mushfiqbinmusa-ops/Laser_Engraver/Laser_XY_3D_Parts/images/IMG_2976.JPG

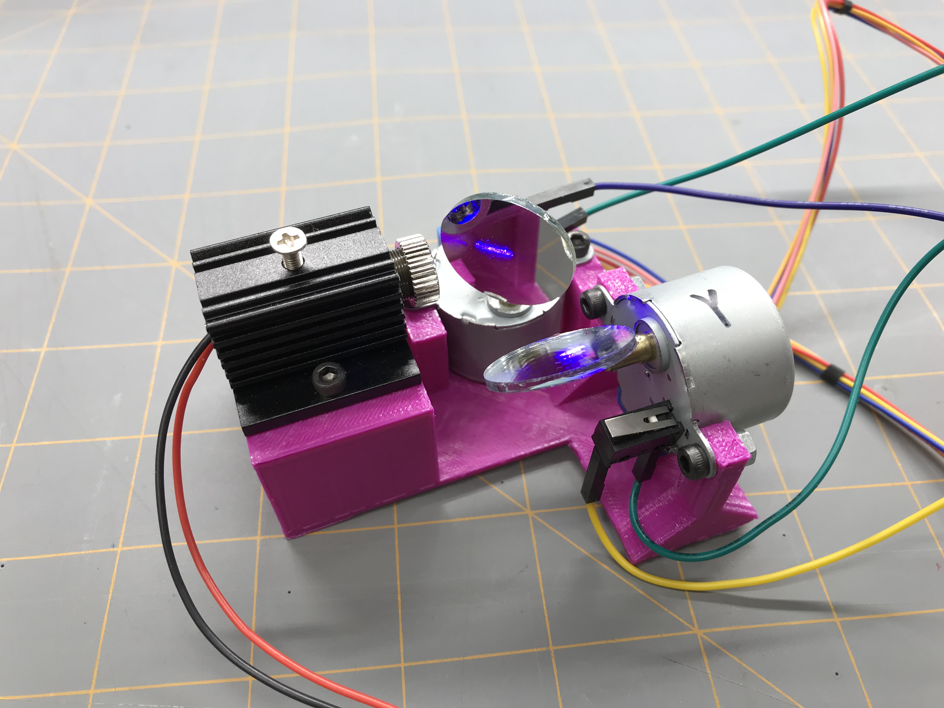
Laser_XY_3D_Parts/images/IMG_2976.JPG
