mushfiqbinmusa-ops/Laser_Engraver/Laser_XY_3D_Parts/images/Laser_XY_Scanner.png

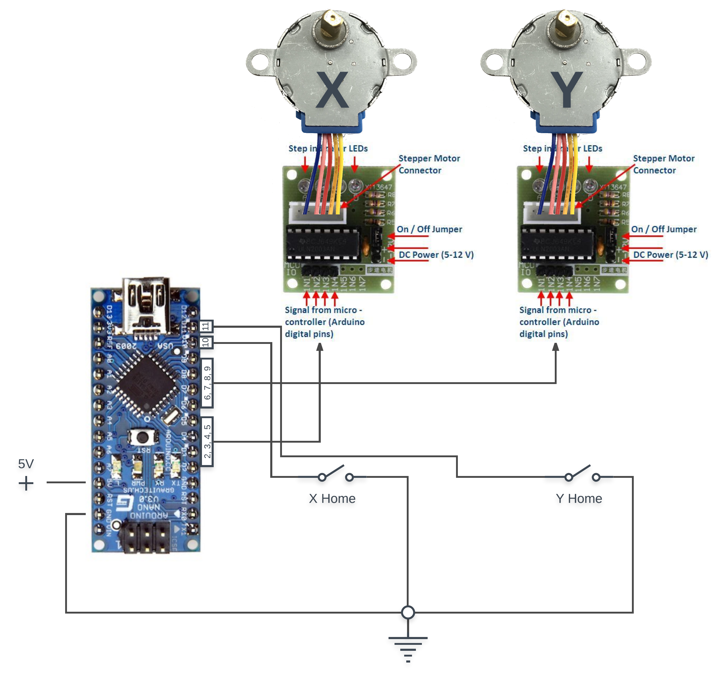
Laser_XY_3D_Parts/images/Laser_XY_Scanner.png
