mushfiqbinmusa-ops/Laser_Engraver/Laser_XY_3D_Parts/README.txt

Laser XY Scanner by thingengineer on Thingiverse: https://www.thingiverse.com/thing:2710048

Summary:
Laser XY ScannerLow Cost DIY 3D Printed stepper motor Laser XY Scanner - Draw, Cut, Engrave, or ScanLaser XY Scanner is an open source stepper motor based scanner.The components used are low cost and very accessible. This typeof laser scanner is not extremely fast but it can still be used in avariety of applications. Draw, cut and or point with laser X and Y control.The circuit:Arduino NanoMonitors small lever switches for X and Y home detection (minimum travel)Controls ULN2003APG high−current darlington driversDrives 28BYJ-48 5V Stepper Motors12V TTL 1W/1.6W/2W/445nm/450nm Laser Diode LD DriverDrives 2W 445nm M140 Blue Laser Diode w/ AixiZ aluminum mount and heat sink for 12mm modulesThe Arduino code can be found in the project repository.GitHub Project: https://github.com/ThingEngineer/Laser-XY-ScannerThe Instructable:https://www.instructables.com/id/Low-Cost-DIY-Stepper-Motor-Laser-XY-Scanner-Cutter/Video of the Laser XY Scanner in action:https://youtu.be/hbFObc3SvLU
