mushfiqbinmusa-ops/Laser_Engraver/resources/28byj48 stepper motor.jpeg

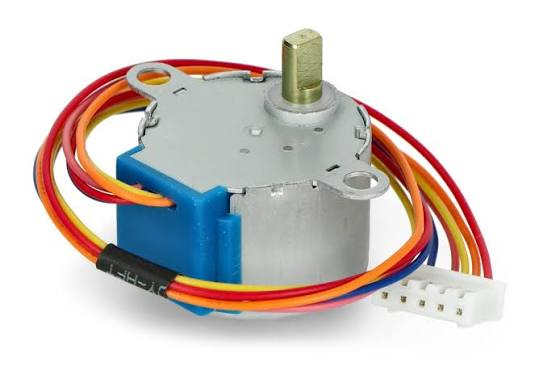
resources/28byj48 stepper motor.jpeg
