mushfiqbinmusa-ops/Laser_Engraver/resources/A4988-Stepper-Motor-Driver-Pinout.webp

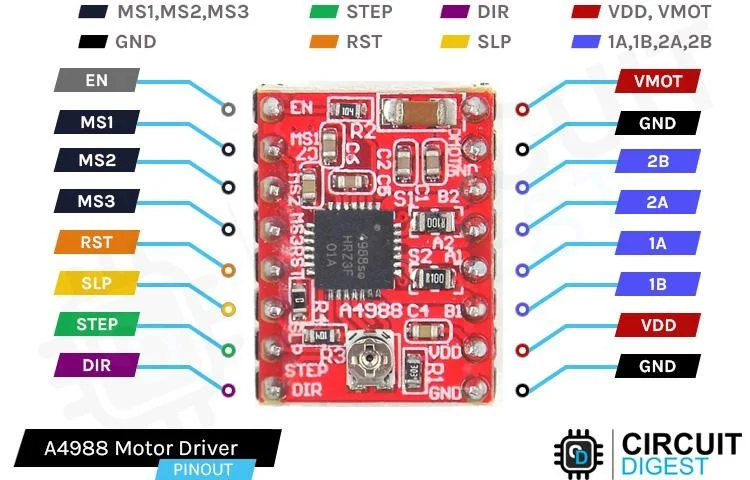
resources/A4988-Stepper-Motor-Driver-Pinout.webp
