mushfiqbinmusa-ops/Laser_Engraver/resources/Infrared Obstacle Avoidance IR Sensor Module.jpeg

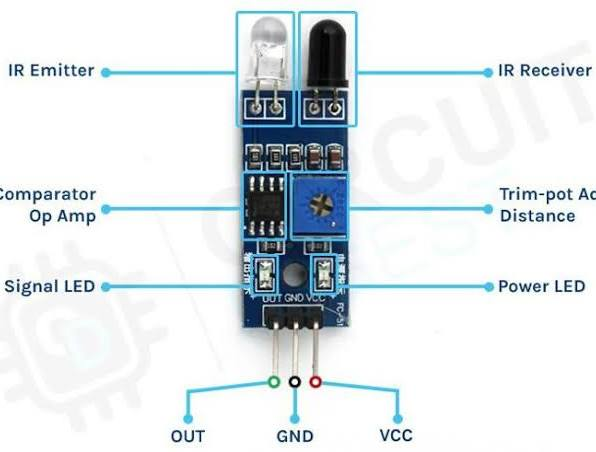
resources/Infrared Obstacle Avoidance IR Sensor Module.jpeg
