mushfiqbinmusa-ops/Laser_Engraver/resources/laser_back_01.jpg

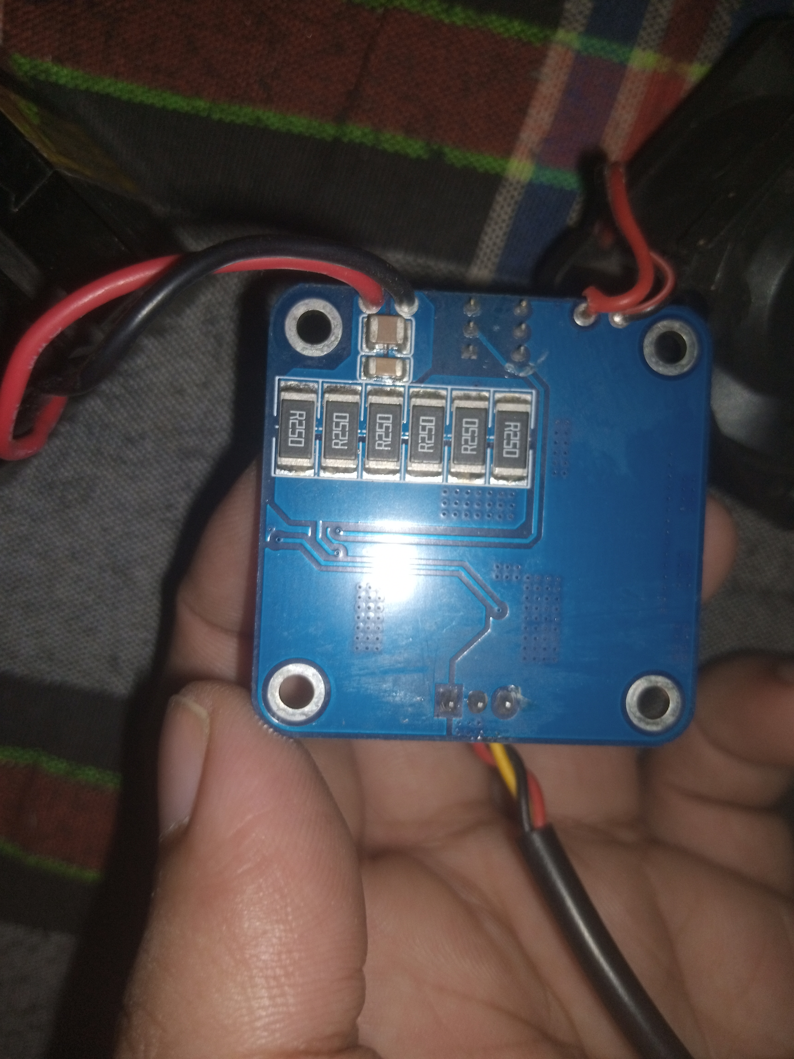
resources/laser_back_01.jpg
