mushfiqbinmusa-ops/Laser_Engraver/resources/laser_front_01.jpg

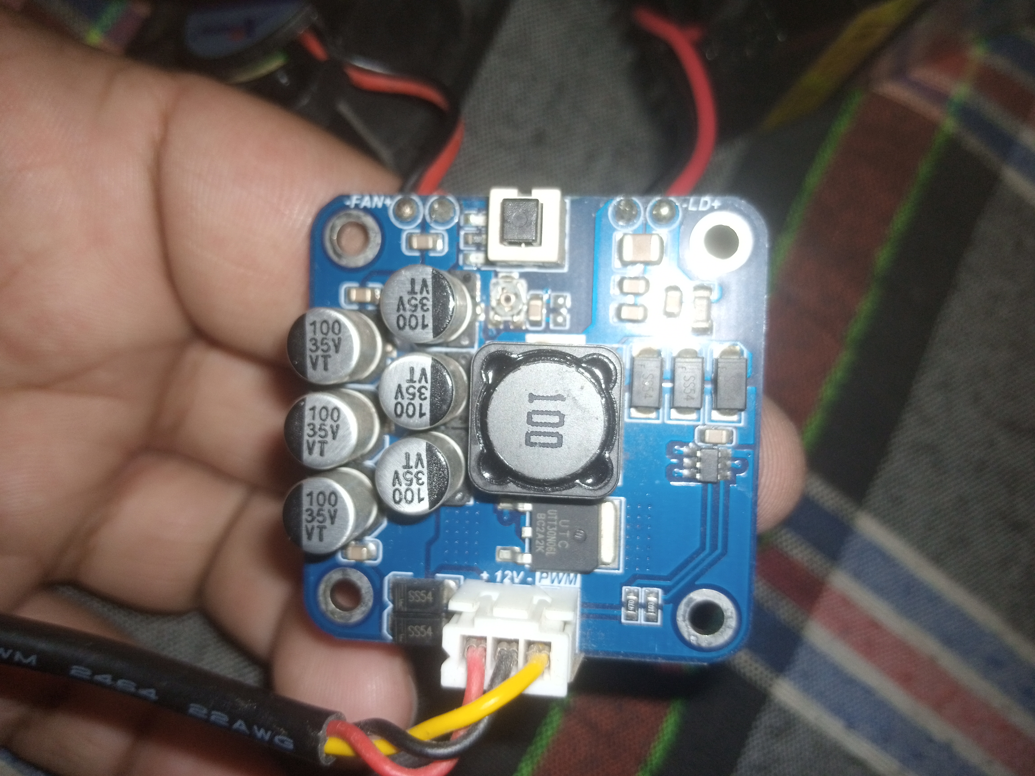
resources/laser_front_01.jpg
