mushfiqbinmusa-ops/Laser_Engraver/resources/laser_front_02.jpg

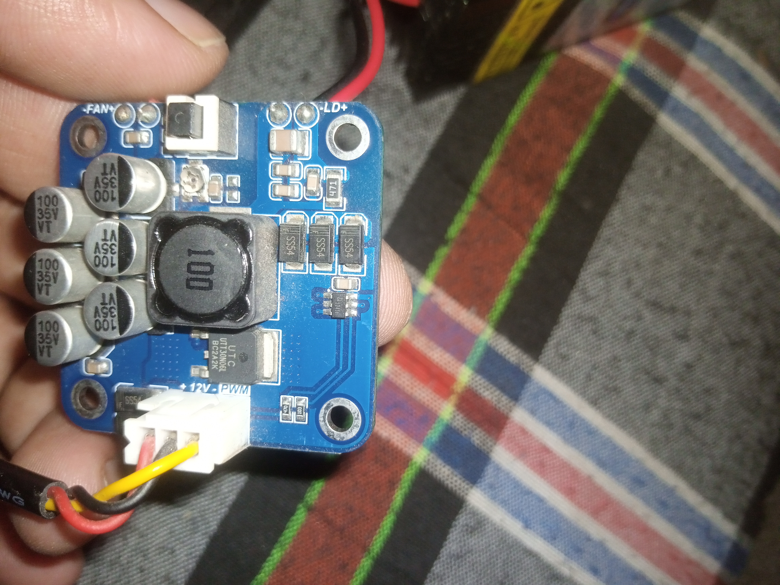
resources/laser_front_02.jpg
