mushfiqbinmusa-ops/Laser_Engraver/Laser XY 3D Parts/images/27eb95fb827bb4617622e574c83647a1.png

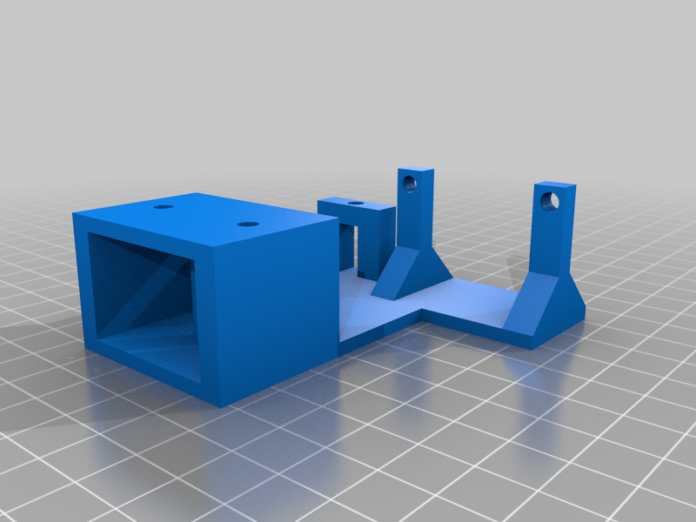
Laser XY 3D Parts/images/27eb95fb827bb4617622e574c83647a1.png
