mushfiqbinmusa-ops/Laser_Engraver/Laser XY 3D Parts/images/Laser_XY_Scanner_2.png

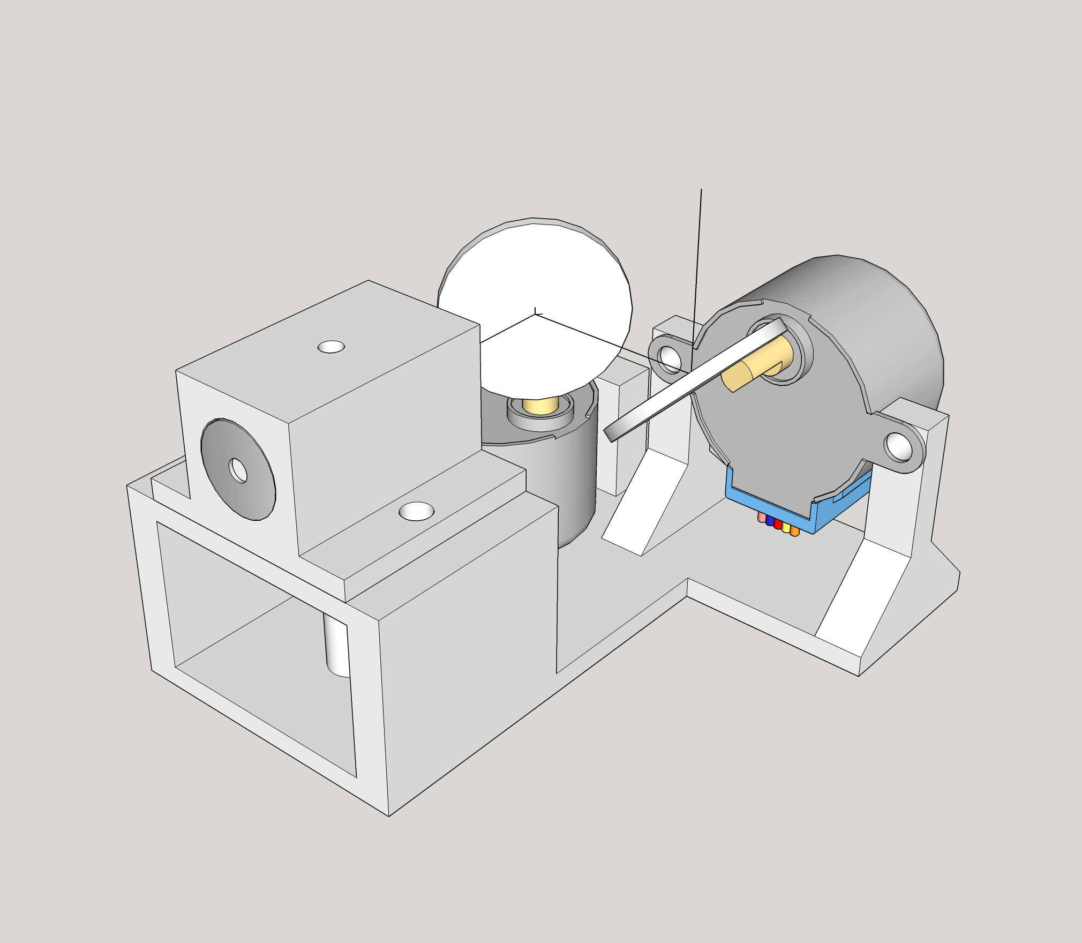
Laser XY 3D Parts/images/Laser_XY_Scanner_2.png
