mushfiqbinmusa-ops/Laser_Engraver/Laser XY 3D Parts/images/Laser_XY_Scanner_3.png

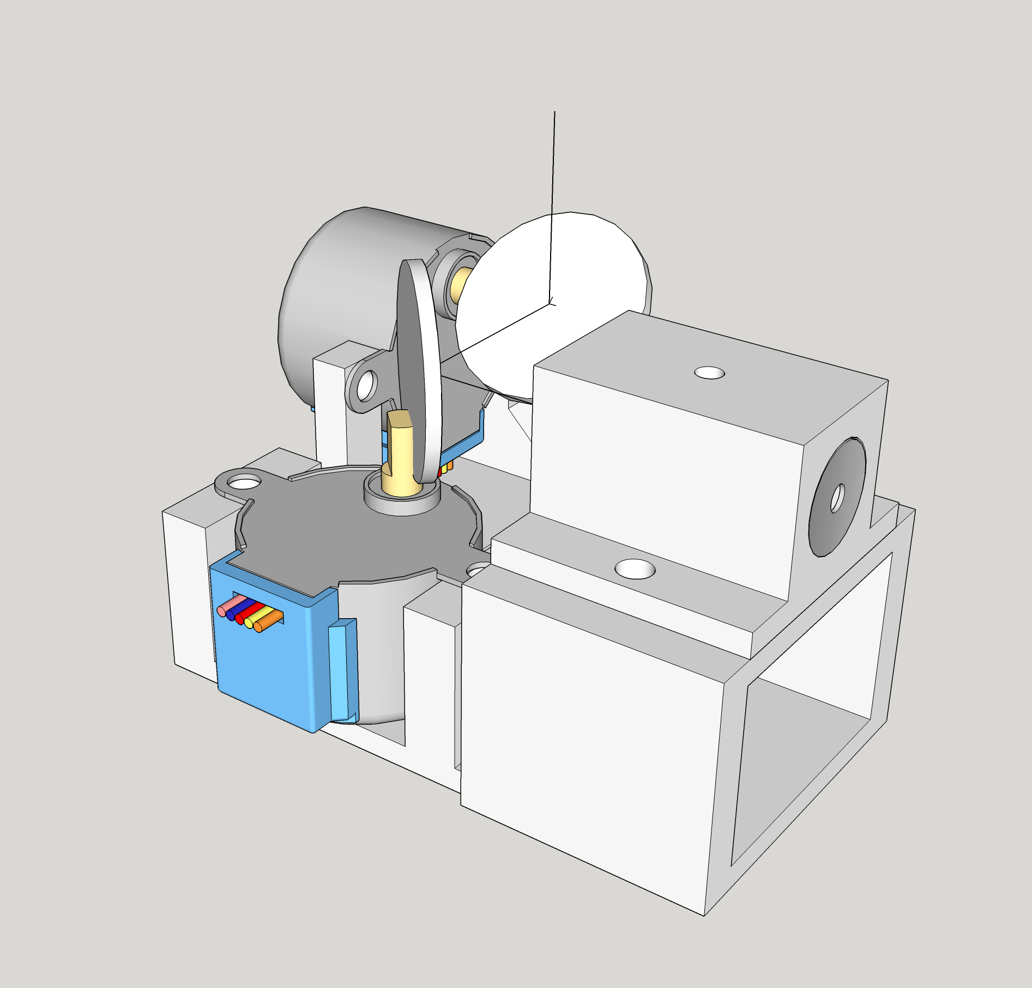
Laser XY 3D Parts/images/Laser_XY_Scanner_3.png
