mushfiqbinmusa-ops/Laser_Engraver/Laser_XY_3D_Parts/images/IMG_2973.JPG

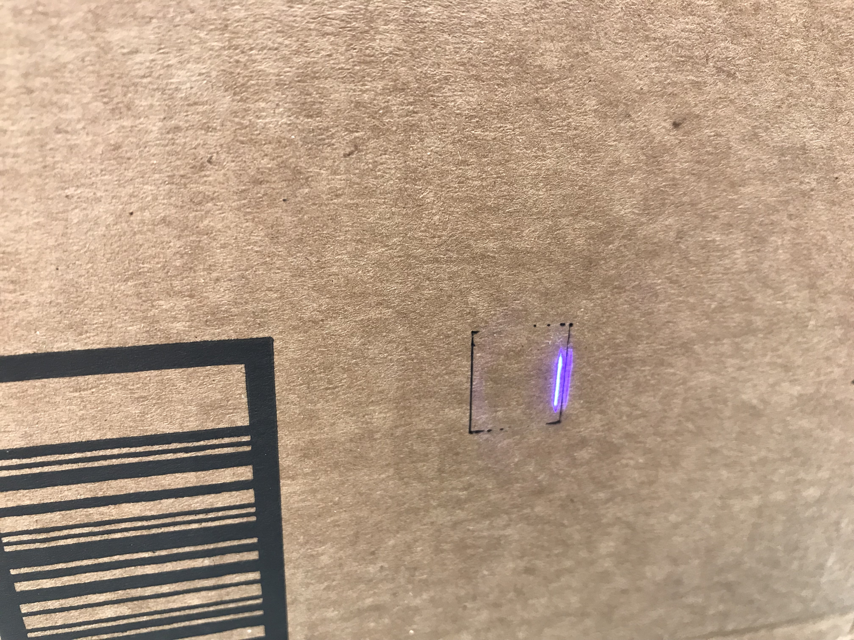
Laser_XY_3D_Parts/images/IMG_2973.JPG
