mushfiqbinmusa-ops/Laser_Engraver/Laser_XY_3D_Parts/images/Laser_XY_Scanner_4.png

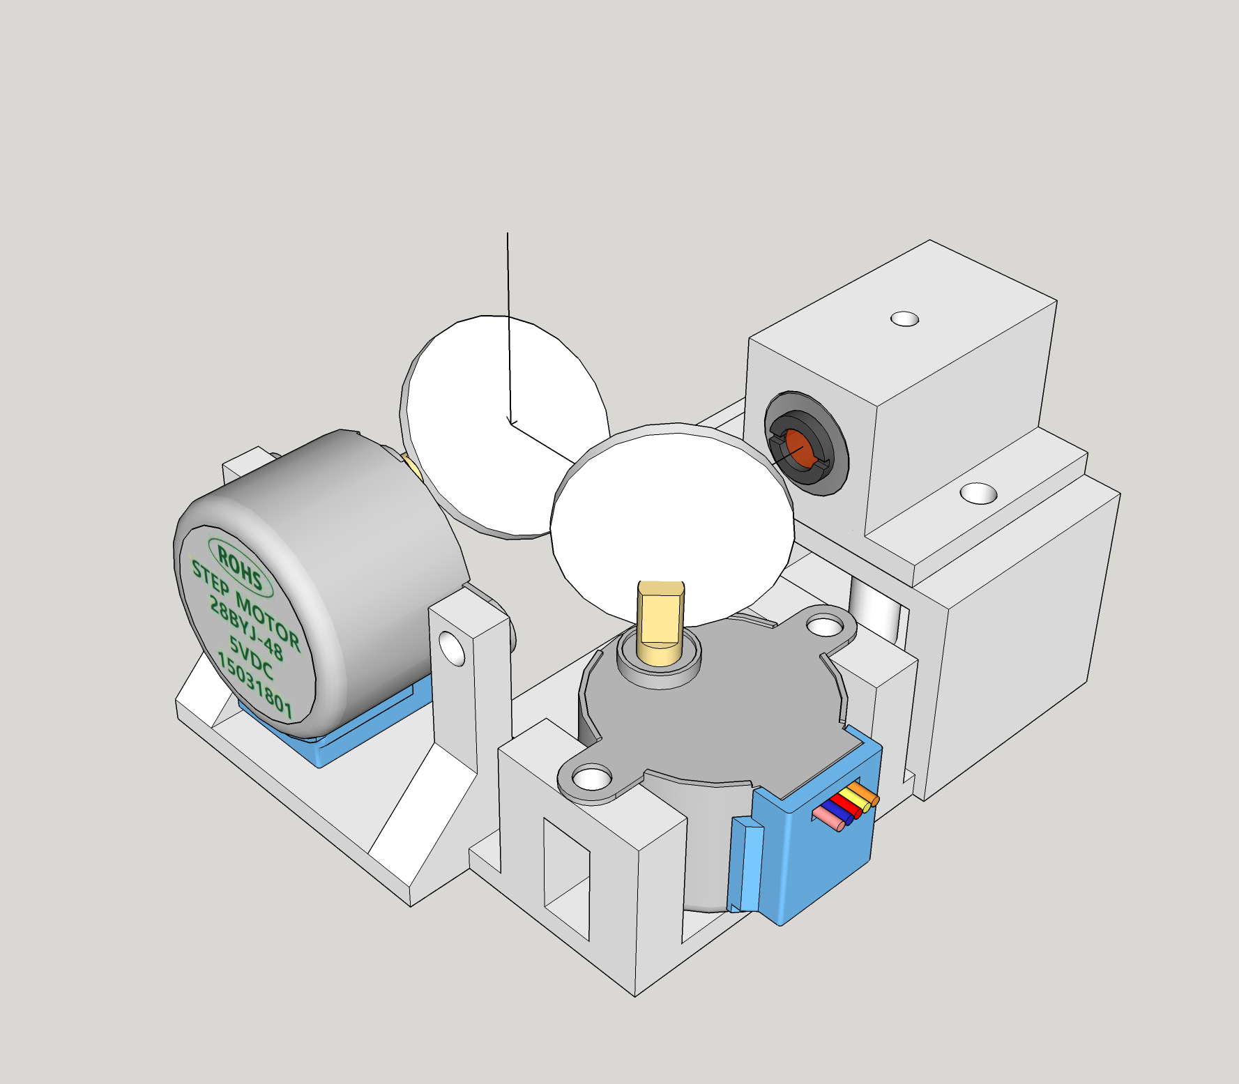
Laser_XY_3D_Parts/images/Laser_XY_Scanner_4.png
