mushfiqbinmusa-ops/Laser_Engraver/Laser_XY_3D_Parts/files/Laser_XY_Scanner.stl

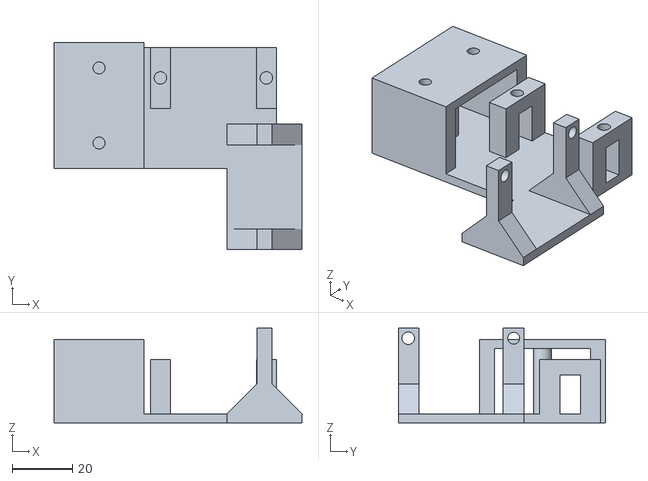
[picture p15: CAD file, 2026-10-16]
Laser_XY_3D_Parts/files/Laser_XY_Scanner.stl
82.5 x 69.0 x 31.6
