mushfiqbinmusa-ops/Laser_Engraver/(list of files, cad)

Other CAD files:
Laser XY 3D Parts/files/Laser_XY_Scanner.skp
Laser_XY_3D_Parts/files/ESP32-S3_SUPERMINI2.glb.skp
