mushfiqbinmusa-ops/Laser_Engraver/stepper_motor_test/TESTING_GUIDE.md

# Dual Stepper Motor & A4988 Driver Test Guide

**Sketch location:** `stepper_motor_test/stepper_motor_test.ino`  
**Target Board:** ESP32-S3 SuperMini  
**Motors:** Dual 28BYJ-48 Stepper Motors (Converted to 4-Wire Bipolar)  
**Drivers:** Dual Allegro A4988 Microstepping Drivers  
**Power Rails:** 5V VMOT (Motor Power) | 3.3V VDD (Logic from ESP32-S3)  
**No external libraries required** — uses standard ESP32 Arduino Core.

---

## Table of Contents

1. [System Architecture & Block Diagram](#1-system-architecture--block-diagram)
2. [28BYJ-48 Bipolar Conversion Guide](#2-28byj-48-bipolar-conversion-guide)
3. [A4988 Driver Specifics & Vref Current Calibration](#3-a4988-driver-specifics--vref-current-calibration)
4. [Circuit Wiring Diagrams & Detailed Component Schematics](#4-circuit-wiring-diagrams--detailed-component-schematics)
   - [Single Motor Test Wiring (Motor A Only)](#41-single-motor-test-wiring-motor-a-only)
   - [Dual Motor Test Wiring (Motor A + Motor B)](#42-dual-motor-test-wiring-motor-a--motor-b)
   - [Capacitor Selection Analysis (Addressing Your Inventory)](#43-capacitor-selection-analysis-addressing-your-inventory)
   - [Step-by-Step Written Wiring Instructions (Foolproof Breadboard Guide)](#44-step-by-step-written-wiring-instructions-foolproof-breadboard-guide)
5. [Microstepping Resolution & Kinematics Table](#5-microstepping-resolution--kinematics-table)
6. [Arduino IDE & Board Configuration](#6-arduino-ide--board-configuration)
7. [Phase-by-Phase Testing Roadmap](#7-phase-by-phase-testing-roadmap)
   - [Phase 1: Cold Logic Verification (VMOT OFF)](#phase-1-cold-logic-verification-vmot-off)
   - [Phase 2: Motor A Rotation & Direction (VMOT ON)](#phase-2-motor-a-rotation--direction-vmot-on)
   - [Phase 3: Speed Characterisation & Stall Limit](#phase-3-speed-characterisation--stall-limit)
   - [Phase 4: Microstepping Transitions (1/1 to 1/16)](#phase-4-microstepping-transitions-11-to-116)
   - [Phase 5: Gear Backlash Characterisation](#phase-5-gear-backlash-characterisation)
   - [Phase 6: Dual-Axis Coordinated Vectoring (Square, Circle)](#phase-6-dual-axis-coordinated-vectoring-square-circle)
   - [Phase 7: Full Automated Self-Test & Benchmark](#phase-7-full-automated-self-test--benchmark)
8. [Troubleshooting Guide](#8-troubleshooting-guide)
9. [Serial Command Reference](#9-serial-command-reference)

---

## 1. System Architecture & Block Diagram

```mermaid
flowchart TD
    subgraph Power["Power Architecture"]
        USB["USB-C 5V Supply"] --> ESP32["ESP32-S3 SuperMini"]
        ESP32 -->|"3.3V Logic Rail"| VDD["VDD (A4988 Logic)"]
        EXT_5V["External 5V / 2A Supply"] -->|"5V VMOT Rail"| VMOT["VMOT (A4988 Motor Power)"]
        GND_SYS["Common Ground Rail (GND)"] --- ESP32
        GND_SYS --- EXT_5V
    end

    subgraph Controller["ESP32-S3 SuperMini"]
        IO5["GPIO 5 (STEP_A)"]
        IO6["GPIO 6 (DIR_A)"]
        IO7["GPIO 7 (EN_A)"]
        IO9["GPIO 9 (STEP_B)"]
        IO10["GPIO 10 (DIR_B)"]
        IO11["GPIO 11 (EN_B)"]
        MS_BUS["Shared Microstep Bus\nGPIO 1 (MS1)\nGPIO 2 (MS2)\nGPIO 4 (MS3)"]
        IO13["GPIO 13 (Status LED)"]
    end

    subgraph Drivers["A4988 Stepper Drivers"]
        subgraph DriverA["Driver A (X-Axis)"]
            DRV_A["A4988 Driver Module"]
            CAP_A["100uF Electrolytic Decoupling Cap"]
        end
        subgraph DriverB["Driver B (Y-Axis)"]
            DRV_B["A4988 Driver Module"]
            CAP_B["100uF Electrolytic Decoupling Cap"]
        end
    end

    subgraph Motors["28BYJ-48 Steppers (Bipolar Mod)"]
        MOT_A["Motor A (X Steering Mirror)\nCoil 1: Blue/Yellow\nCoil 2: Pink/Orange"]
        MOT_B["Motor B (Y Steering Mirror)\nCoil 1: Blue/Yellow\nCoil 2: Pink/Orange"]
    end

    IO5 --> DRV_A
    IO6 --> DRV_A
    IO7 --> DRV_A
    IO9 --> DRV_B
    IO10 --> DRV_B
    IO11 --> DRV_B
    MS_BUS --> DRV_A
    MS_BUS --> DRV_B

    VMOT --> CAP_A --> DRV_A
    VMOT --> CAP_B --> DRV_B
    VDD --> DRV_A
    VDD --> DRV_B

    DRV_A --> MOT_A
    DRV_B --> MOT_B
```

---

## 2. 28BYJ-48 Bipolar Conversion Guide

The stock 28BYJ-48 is a 5-wire unipolar stepper driven by Darlington arrays (e.g. ULN2003A). In unipolar mode, only half of each coil carries current at any given instant. 

By converting the motor to a **4-wire bipolar configuration**, both phases are driven symmetrically by an H-bridge driver (A4988), doubling torque production, improving efficiency, and allowing microstepping.

### Step-by-Step Conversion Procedure

1. **Remove Blue Plastic Cover:**
   - Gently pry the small tabs of the blue plastic cap on the rear of the 28BYJ-48 using a hobby knife or flat miniature screwdriver.
   - Slide the cap off to expose the internal small printed circuit board (PCB) where the 5 colored leads are soldered.

2. **Locate the Center Tap Trace:**
   - You will see 5 solder pads: `Blue`, `Pink`, `Yellow`, `Orange`, and `Red`.
   - The `Red` wire is the center tap. A trace runs across the PCB connecting the red wire's solder pad to the midpoint of the internal coils.

3. **Cut the PCB Trace:**
   - With an X-Acto knife or sharp razor, carefully scrape/slice through the copper trace running between the red pad and the center connection.
   - Cut through until the underlying substrate is visible. Ensure no stray copper burrs bridge the cut.

4. **Isolate or Desolder the Red Wire:**
   - Snip the red wire flush at the PCB, or heat shrink its free end. It will **not** be connected to the A4988.

5. **Verify with a Multimeter (DMM):**
   - Measure resistance between **Blue** and **Yellow**: Should measure approximately **30 Ω to 50 Ω** (or ~95–105 Ω depending on model) (**Phase 1**).
   - Measure resistance between **Pink** and **Orange**: Should measure approximately **30 Ω to 50 Ω** (or ~95–105 Ω) (**Phase 2**).
   - Measure resistance between **Red** and **any other wire**: Must read **infinite (open circuit / OL)**.
   - Measure resistance between **Blue** and **Pink**: Must read **infinite (isolated phases)**.

### Wiring Assignment to A4988

| Motor Wire Color | Motor Phase | A4988 Pin |
|---|---|---|
| **Blue** | Phase 1 (+) | **1A** |
| **Yellow** | Phase 1 (-) | **1B** |
| **Pink** | Phase 2 (+) | **2A** |
| **Orange** | Phase 2 (-) | **2B** |
| **Red** | Cut Center Tap | **NC (Disconnected)** |

> [!TIP]
> If a motor rotates in reverse of your desired direction, you can either issue the firmware command `DIR B CCW` or simply swap the two wires of one coil (e.g. swap Blue and Yellow).

> [!NOTE]
> **Verified Hardware Note (Bipolar Coil Pairing):**
> On this project's converted 28BYJ-48 motors, the true internal coil pairs after cutting the center tap are:
> - **Coil Pair 1:** Blue & Yellow $\to$ A4988 `1A` & `1B`
> - **Coil Pair 2:** Pink & Orange $\to$ A4988 `2A` & `2B`
> 
> *Fix confirmed:* If paired incorrectly (e.g. Blue/Pink and Yellow/Orange), the motor will only spin in a single direction regardless of `DIR` voltage. Wiring according to the verified pairs above completely resolves the bidirectional rotation issue.

---

## 3. A4988 Driver Specifics & Vref Current Calibration

### Essential Hardware Pin Strapping

1. **RST and SLP Tied Together:**
   - The A4988 `~RESET` and `~SLEEP` pins are active LOW logic inputs.
   - Jumper `RESET` directly to `SLEEP`. The driver's internal pull-up on SLEEP holds RESET high, keeping the driver active.
2. **ENABLE Pin Control:**
   - The `~ENABLE` pin is **active LOW**.
   - Connected to ESP32 GPIO: `LOW` = Driver energized; `HIGH` = Outputs high-impedance (de-energized, cool idle).
3. **VMOT Decoupling Capacitor Selection (Is 100 µF Mandatory?):**
   - **No, 100 µF is NOT strictly mandatory — it is simply the typical nominal value recommended in the Pololu datasheet!**
   - **Any electrolytic capacitor from 47 µF up to 1000 µF rated at 16V or 25V is completely safe and effective for your 5V VMOT setup:**
     - **`47 µF (16V or 25V)`:** Acceptable for a single driver bench test. (Small, easy to fit on breadboard).
     - **`470 µF (16V or 25V)` [RECOMMENDED OPTION]:** **The sweet spot!** Provides exceptional transient absorption, dampens inductive coil kickback, and filters switching ripple significantly better than 100 µF without causing excessive power-on inrush current.
     - **`1000 µF (25V)`:** Also completely safe electrically. However, its physical barrel size is large on a breadboard, and charging a 1000 µF cap draws a momentary inrush pulse when switching on 5V.
     - **Voltage Rating Check:** Since your motor supply is **5V DC**, both **16V** and **25V** capacitors provide more than 3x to 5x voltage headroom (derating rule requires capacitor rated $\ge 1.5 	imes V_{	ext{rail}}$), so both are 100% safe.
   - **Polarity Warning:** Observe electrolytic polarity! The stripe with **minus signs (-)** connects to **GND**, and the longer lead (+) connects to **VMOT**.
   - **Crucial Rule:** Always keep the capacitor physically close to the A4988 VMOT and GND pins. Never plug or unplug a stepper motor while VMOT is energized — inductive flyback spikes will blow the driver FETs.

### Current Limit Setting ($V_{ref}$ Formula)

The 28BYJ-48 converted to bipolar has a DC coil resistance of $\approx 100\,\Omega$. When running on a 5V supply, the natural continuous DC current is:
$$I = \frac{5\,\text{V}}{100\,\Omega} = 50\,\text{mA}$$

To achieve fast step transitions and overcome gear inertia at higher step rates, the A4988 chopper is calibrated between **150 mA and 200 mA** per phase ($I_{max}$).

The Allegro A4988 current trip formula is:
$$I_{max} = \frac{V_{ref}}{8 \times R_s}$$

Where $R_s$ is the onboard current sense resistor.

#### Identifying Your Current Sense Resistors ($R_s$)
Inspect the two small surface-mount resistors on the A4988 module near the chip:
- Resistor labeled `R100` $\implies R_s = 0.10\,\Omega$ *(Most common on Pololu and standard modules)*
- Resistor labeled `R050` $\implies R_s = 0.05\,\Omega$
- Resistor labeled `R200` $\implies R_s = 0.20\,\Omega$

#### Target $V_{ref}$ Calculation Table

For the standard $R_s = 0.10\,\Omega$ module:
$$V_{ref} = I_{max} \times 8 \times R_s = I_{max} \times 0.8$$

| Target Phase Current ($I_{max}$) | $R_s = 0.10\,\Omega$ ($V_{ref}$) | $R_s = 0.05\,\Omega$ ($V_{ref}$) | Thermal Profile |
|---|---|---|---|
| **120 mA** | **0.096 V (96 mV)** | 0.048 V (48 mV) | Cool, low torque |
| **150 mA (Recommended)** | **0.120 V (120 mV)** | 0.060 V (60 mV) | **Optimal balance of torque & heat** |
| **180 mA** | **0.144 V (144 mV)** | 0.072 V (72 mV) | High torque, warm motor |
| **200 mA (Max)** | **0.160 V (160 mV)** | 0.080 V (80 mV) | Maximum torque, hot motor |

### How to Adjust $V_{ref}$:
1. Connect the ESP32-S3 logic ground (`GND`) to your multimeter's negative black lead (e.g. using an alligator clip).
2. Set multimeter to DC Volts (millivolt range, e.g. 200 mV or 2 V DC).
3. Connect 3.3V logic supply to A4988 `VDD` and `GND` (motor 5V VMOT can be ON or OFF during measurement).
4. Touch the multimeter's red probe carefully to the metal top of the small onboard potentiometer (trimpot).
5. Using a miniature ceramic or insulated screwdriver, gently rotate the trimpot until the meter reads **120 mV (0.12 V)**.
   - Clockwise usually increases voltage; counter-clockwise decreases it.

---

## 4. Circuit Wiring Diagrams & Detailed Component Schematics

> [!TIP]
> ### 🌟 Interactive Dynamic HTML Schematic Available!
> For an animated, interactive visual schematic with signal pulsing, pin tooltips, and a **Single Motor vs Dual Motor toggle**, open:  
> **👉 [`stepper_motor_test/circuit_diagram.html`](file:///home/mushfiq/Desktop/Laser-XY-Scanner/stepper_motor_test/circuit_diagram.html)** directly in your web browser!

> [!NOTE]
> ### 💡 Is `stepper_motor_test.ino` for both Single and Dual Stepper Testing?
> **YES!** `stepper_motor_test.ino` is a unified, all-in-one test suite designed for both stages:
> 1. **Phase 1 (Single Stepper Bring-Up):** Wire only **Motor A (X-Axis)**. Motor B's pins are held inactive. You can run all single-axis commands (`STEP <n>`, `SPEED <sps>`, `START <sps>`, `STOP`, `REV <n>`, `BACKLASH`, `STALL`).
> 2. **Phase 2 (Dual Stepper Coordinated Testing):** Add **Motor B (Y-Axis)** when ready. You can test both motors together with vector interpolation commands (`DUAL STEP <nA> <nB>`, `DUAL GOTO <xA> <yB>`, `DUAL CIRCLE <r>`, `DUAL SQUARE <s>`).
>
> You do **not** need a separate sketch—the single firmware safely accommodates both wiring states!

---

### 4.0 Component Pinout References

#### 1. ESP32-S3 SuperMini Physical Header Pinout (Top View)
*(Castellated 18-pin DIP footprint: 9 pins Left, 9 pins Right, USB-C at Top)*
```
                  ┌────────────────────────┐
                  │      [ USB-C PORT ]    │
                  │                        │
       5V Power   │ [5V]              [5]  │ Motor A STEP (GPIO 5)
     Common GND   │ [GND]             [6]  │ Motor A DIR (GPIO 6)
     3.3V Logic   │ [3V3]             [7]  │ Motor A EN (GPIO 7, Active LOW)
  UART0 TX (IO43) │ [TX]              [8]  │ Unused GPIO (GPIO 8)
  UART0 RX (IO44) │ [RX]              [9]  │ Motor B STEP (GPIO 9)
   MS1 Shared Bus │ [1]              [10]  │ Motor B DIR (GPIO 10)
   MS2 Shared Bus │ [2]              [11]  │ Motor B EN (GPIO 11, Active LOW)
   Unused / Strap │ [3]              [12]  │ Unused GPIO (GPIO 12)
   MS3 Shared Bus │ [4]              [13]  │ Onboard Status LED (GPIO 13)
                  │                        │
                  └────────────────────────┘
```
*(Notice: The outer DIP headers expose power `5V`, `GND`, `3V3`, serial `TX`/`RX`, and GPIOs `1` through `13`. Pin `4` (GPIO 4) is utilized for MS3 because it is physically exposed on the outer header, completely avoiding the need to solder to underside pads!)*

#### 2. Allegro A4988 Module Physical Pinout (Top View)
```
                     ┌──────────────────┐
                     │   [TRIMPOT VREF] │
       Enable (LOW)  │ [ENABLE]  [VMOT] │ Motor DC Supply (5V)
    Microstep Bit 1  │ [MS1]      [GND] │ Motor Ground
    Microstep Bit 2  │ [MS2]       [2B] │ Coil 2 (-)  --> Orange Wire
    Microstep Bit 3  │ [MS3]       [2A] │ Coil 2 (+)  --> Pink Wire
       Reset Input   │ [RESET]     [1A] │ Coil 1 (+)  --> Blue Wire
       Sleep Input   │ [SLEEP]     [1B] │ Coil 1 (-)  --> Yellow Wire
         Step Pulse  │ [STEP]     [VDD] │ Logic Power (3.3V from ESP32)
    Direction Logic  │ [DIR]      [GND] │ Logic Ground (Common GND)
                     └──────────────────┘
```

#### 3. Converted 28BYJ-48 4-Wire Bipolar Stepper Pinout
```
                ┌───────────────────────────────────┐
                │     28BYJ-48 Stepper Motor        │
                │        (Bipolar Modded)           │
                │                                   │
                │   [Coil Phase 1 (~50-100 Ω)]      │
                │   • Blue Wire   ──────> A4988 1A  │
                │   • Yellow Wire ──────> A4988 1B  │
                │                                   │
                │   [Coil Phase 2 (~50-100 Ω)]      │
                │   • Pink Wire   ──────> A4988 2A  │
                │   • Orange Wire ──────> A4988 2B  │
                │                                   │
                │   [Cut Center Tap]                │
                │   • Red Wire    ──────> NOT USED  │
                │                         (Cut/NC)  │
                └───────────────────────────────────┘
```

---

### 4.1 Single Motor Test Wiring (Motor A Only)

For initial bring-up, current calibration, and single-axis speed tuning:

```
+================================================================================================================+
|                                SINGLE MOTOR (MOTOR A) BENCH TEST SCHEMATIC                                     |
+================================================================================================================+

       +------------------------------------+
       |        ESP32-S3 SuperMini          |
       |                                    |
       | (Left Row)            (Right Row)  |
       |   [3V3] ───────────────────────────┼───────────────────────────────┐
       |   [GND]  ──+                       |                               │
       |            │ (Common GND)          |                               │
       |   [1]   ───┼─────────────────┐     |                               │
       |   [2]   ───┼───────────┐     │     |                               │
       |   [4]   ───┼─────┐     │     │     |                               │
       |            │     │     │     │     │   [5] (STEP) ─────────────────┤
       |            │     │     │     │     │   [6] (DIR)  ───────────┐     │
       |            │     │     │     │     │   [7] (EN)   ─────┐     │     │
       +------------+-----│-----│-----│-----+-----------------│-----│-----│-----+
                          │     │     │                       │     │     │
                          │     │     │                       v     v     v
                       +--┴─────┴─────┴───────────────────────┴─────┴─────┴───────+
                       | MS3   MS2   MS1                     EN    DIR   STEP VDD |
                       |                                                         |
                       |                     A4988 DRIVER MODULE                 |
                       |                          (MOTOR A)                      |
                       |                                                         |
                       | [RESET]  [SLEEP]    2B    2A    1A    1B   GND    VMOT  |
                       +----┬────────┬--------┬─────┬─────┬─────┬────┬───────┬---+
                            │        │        │     │     │     │    │       │
                            +──Jumper+        │     │     │     │    │       │
                            (Tied Together)   │     │     │     │    │       │
                                              │     │     │     │    │       │
              +-------------------------------+     │     │     │    │       │
              | Orange Wire                         │     │     │    │       │
              |        +----------------------------+     │     │    │       │
              |        | Pink Wire                        │     │    │       │
              |        |        +-------------------------+     │    │       │
              |        |        | Blue Wire                     │    │       │
              |        |        |        +----------------------+    │       │
              |        |        |        | Yellow Wire               │       │
              v        v        v        v                           │       │
       +------------------------------------+                        │       │
       |       28BYJ-48 Stepper Motor       |                        │       │
       |       Phase 2        Phase 1       |                        │       │
       |    [Pink/Orange]  [Blue/Yellow]    |                        │       │
       |                                    |                        │       │
       |    Red Wire (Center-Tap): CUT / NC |                        │       │
       +------------------------------------+                        │       │
                                                                     │       │
       +------------------------------------+                        │       │
       |   ESP32 5V PIN OR 5V BENCH SUPPLY  |                        │       │
       |                                    |                        │       │
       |   [+5V Output] ────────────────────┼────────────────────────┼───────┘
       |                                    |                        │
       |   [GND Output] ────────────────────┼───────────┬────────────┘
       +------------------------------------+           │
                         │                              │
                         │           +───────────[ - ]──┴─────────────────+
                         │           |  ELECTROLYTIC FILTER CAPACITOR     |
                         │           |  47uF, 470uF, or 1000uF (16V / 25V)|
                         │           |  (470uF 25V Recommended)           |
                         │           +───────────[ + ]──┬─────────────────+
                         │                              │
                         +──────────────────────────────┴──────────────────> Ties to VMOT
                         │
                         v
                [ COMMON SYSTEM GND ] <═════ Tied to ESP32-S3 [GND] pin
```

---

### 4.2 Dual Motor Test Wiring (Motor A + Motor B)

This schematic connects both Motor A (X-Mirror) and Motor B (Y-Mirror) to the ESP32-S3 SuperMini, using a **shared 3-wire microstepping bus** (MS1, MS2, MS3) and independent STEP, DIR, and ENABLE control lines.

```
+==================================================================================================================+
|                                    DUAL MOTOR BENCH TEST FULL SCHEMATIC                                          |
+==================================================================================================================+

                                             ESP32-S3 SuperMini
                                     ┌─────────────────────────────────┐
                       USB 5V Supply │ [5V]                        [5] ├─── Motor A STEP (GPIO 5)
               Common System GND Bus │ [GND]                       [6] ├─── Motor A DIR (GPIO 6)
               Common 3.3V Logic Bus │ [3V3]                       [7] ├─── Motor A EN (GPIO 7, Active LOW)
                     UART0 TX Serial │ [TX]                        [8] │    (Available GPIO 8)
                     UART0 RX Serial │ [RX]                        [9] ├─── Motor B STEP (GPIO 9)
                      MS1 Shared Bus │ [1]                        [10] ├─── Motor B DIR (GPIO 10)
                      MS2 Shared Bus │ [2]                        [11] ├─── Motor B EN (GPIO 11, Active LOW)
                      Unused / Strap │ [3]                        [12] │    (Available GPIO 12)
                      MS3 Shared Bus │ [4]                        [13] ├─── Status LED (GPIO 13)
                                     └─────────────────────────────────┘
                                        │   │   │   │   │   │   │   │
                     ┌──────────────────┘   │   │   │   │   │   │   └───────────────────────────────┐
                     │                      │   │   │   │   │   └───────────────────────┐       │
                     │  ┌───────────────────┘   │   │   │   └───────────────┐       │       │       │
                     │  │                       │   │   └───────────┐   │       │       │       │       │
                     │  │  ┌────────────────────┘   │               │   │       │       │       │       │
                     │  │  │                        └───────┐       │   │       │       │       │       │
                     │  │  │  ┌─────────────────────────────┼───────┼───┼───────┼───────┼───────┼──┐    │
                     │  │  │  │                             │       │   │       │       │       │  │    │
                     v  v  v  v                             │       │   │       │       │       v  v    v
                 +-------------------+                      │       │   │       │      +-------------------+
                 | EN  DIR STEP VDD  |                      │       │   │       │      | EN  DIR STEP VDD  |
                 |                   |                      │       │   │       │      |                   |
                 |   A4988 DRIVER    |                      │       │   │       │      |   A4988 DRIVER    |
                 |     MODULE A      |                      │       │   │       │      |     MODULE B      |
                 |     (X-AXIS)      |                      │       │   │       │      |     (Y-AXIS)      |
                 |                   |                      │       │   │       │      |                   |
                 | MS1 MS2 MS3 RESET |                      │       │   │       │      | MS1 MS2 MS3 RESET |
                 | GND VMOT    SLEEP |                      │       │   │       │      | GND VMOT    SLEEP |
                 | 1B  1A  2A  2B    |                      │       │   │       │      | 1B  1A  2A  2B    |
                 +--┬──┬──┬──┬──┬─┬--+                      │       │   │       │      +--┬──┬──┬──┬──┬─┬--+
                    │  │  │  │  │ │                         │       │   │       │         │  │  │  │  │ │
          MS1 Bus ──┼──┼──┼──┼──┼─┼─────────────────────────┼───────┼───┼───────┼─────────┘  │  │  │  │ │
          MS2 Bus ──┼──┼──┼──┼──┼─┼─────────────────────────┼───────┼───┼───────┴────────────┘  │  │  │ │
          MS3 Bus ──┼──┼──┼──┼──┼─┼─────────────────────────┼───────┼───┼───────────────────────┘  │  │ │
                    │  │  │  │  │ └──[RESET tied to SLEEP]  │       │   │                          │  │ └──[RESET tied to SLEEP]
                    │  │  │  │  │                           v       v   v                          │  │
                    │  │  │  │  │                         [From ESP32-S3]                          │  │
                    │  │  │  │  │                         IO11   IO10  IO9                         │  │
                    │  │  │  │  │                         (EN)  (DIR) (STEP)                       │  │
                    │  │  │  │  │                           │       │   │                          │  │
                    │  │  │  │  │                           └───────┼───┼──────────────────────────┘  │
                    │  │  │  │  │                                   └───┼─────────────────────────────┘
                    │  │  │  │  │                                       └─────────────────────────────┘
                    │  │  │  │  │
                    │  │  │  │  │   +-------------------------+     +-------------------------+
                    │  │  │  │  │   | 28BYJ-48 MOTOR A (X)    |     | 28BYJ-48 MOTOR B (Y)    |
                    │  │  │  │  │   |   Coil 1:               |     |   Coil 1:               |
                    │  │  │  │  └───┤     • 1B -> Yellow      |     |     • 1B -> Yellow      ├─────┐
                    │  │  │  └──────┤     • 1A -> Blue        |     |     • 1A -> Blue        ├──┐  │
                    │  │  └─────────┤   Coil 2:               |     |   Coil 2:               |  │  │
                    │  └────────────┤     • 2A -> Pink        |     |     • 2A -> Pink        ├┐ │  │
                    │  └────────────┤     • 2B -> Orange      |     |     • 2B -> Orange      ├┼─┘  │
                                    |                         |     |                         |│ │  │
                                    |   Red Wire: Cut / NC    |     |   Red Wire: Cut / NC    |│ │  │
                                    +-------------------------+     +-------------------------+│ │  │
                                                                                               │ │  │
                                             ┌─────────────────────────────────────────────────┘ │  │
                                             ├───────────────────────────────────────────────────┘  │
                                             ├──────────────────────────────────────────────────────┘
                                             │
      +======================================┴======================================================+
      |                                  POWER DISTRIBUTION NETWORK                                 |
      +=============================================================================================+

       5V Motor Power Supply                       Driver A Filter Cap             Driver B Filter Cap
      ┌─────────────────────┐                   ┌────────────────────────┐      ┌────────────────────────┐
      │  +5V DC Rail        ├───────────────────┤ (+) 47uF to 1000uF     ├──────┤ (+) 47uF to 1000uF     ├──> VMOT (Both A4988)
      │                     │                   │     (470uF 16/25V rec) │      │     (470uF 16/25V rec) │
      │  GND Rail           ├──┬────────────────┤ (-)                    ├──┬───┤ (-)                    ├──> GND (Both A4988)
      └─────────────────────┘  │                └────────────────────────┘  │   └────────────────────────┘
                               │                                            │
                               v                                            v
                      [ STAR GROUND POINT ] <═══════════════════════════════╧═══> Tied to ESP32-S3 GND
```

---

### 4.3 Capacitor Selection Analysis (Addressing Your Inventory)

You asked whether the **100 µF capacitor is mandatory** and noted that you have **1000 µF, 47 µF, and 470 µF capacitors rated at 16V and 25V**. Here is the definitive engineering analysis:

| Your Capacitor | Voltage Rating | Verdict | Detailed Technical Assessment |
|---|---|---|---|
| **`470 µF`** | **16V or 25V** | **BEST CHOICE (RECOMMENDED)** | **The ideal capacitor.** 470 µF provides nearly 5x the charge reservoir of 100 µF, significantly smoothing the motor switching ripple and absorbing inductive back-EMF without drawing an excessive power-on inrush current. Fits comfortably on a breadboard. |
| **`1000 µF`** | **25V** | **FULLY COMPATIBLE & SAFE** | Electrically safe and provides massive bulk capacitance. It will easily handle both motors. Note: When first connected to 5V, it draws a momentary inrush spike as it charges up; ensure your 5V supply does not trip. |
| **`47 µF`** | **16V or 25V** | **ACCEPTABLE (Single Motor)** | Perfectly fine for single-motor bring-up and characterization. Slightly small for dual simultaneous rapid acceleration, but completely safe. |

#### Voltage Rating Verification:
- **Your Supply:** 5V DC VMOT.
- **Capacitor Ratings:** 16V and 25V.
- **Rule of Thumb:** Working voltage should be $\ge 1.5 \times V_{\text{rail}}$ (i.e. $\ge 7.5\,\text{V}$).
- **Result:** Both **16V** ($3.2\times$ safety margin) and **25V** ($5\times$ safety margin) have massive headroom and will never suffer overvoltage breakdown.

#### Installation Rules:
1. **Polarity:** Always connect the negative lead (marked with a white stripe and minus symbols `-`) to **GND**, and the positive lead (longer leg) to **VMOT**.
2. **Proximity:** Position the capacitor as close as physically possible to the A4988 `VMOT` and `GND` pins on the breadboard (within 1 to 2 cm) to minimize wire inductance.
---

### 4.4 Step-by-Step Written Wiring Instructions (Foolproof Breadboard Guide)

Follow these step-by-step written instructions carefully when assembling your test setup on a solderless breadboard. This guide eliminates all guesswork regarding pin orientations, wire paths, jumper links, and safety precautions.

---

#### 4.4.1 Breadboard Layout & Component Placement

1. **Place the ESP32-S3 SuperMini:**
   - Mount the ESP32-S3 SuperMini straddling the center divider groove on one side of the breadboard, with the **USB-C connector pointing towards the top edge**.
   - Note the two 9-pin rows:
     - **Left Row (Pins 1–9, top to bottom):** `5V`, `GND`, `3V3`, `TX`, `RX`, `1` (GPIO 1), `2` (GPIO 2), `3` (GPIO 3), `4` (GPIO 4).
     - **Right Row (Pins 1–9, top to bottom):** `5` (GPIO 5), `6` (GPIO 6), `7` (GPIO 7), `8` (GPIO 8), `9` (GPIO 9), `10` (GPIO 10), `11` (GPIO 11), `12` (GPIO 12), `13` (GPIO 13).
2. **Place A4988 Driver Module A (X-Axis):**
   - Insert Driver Module A into the breadboard straddling the center divider groove.
   - **Crucial Orientation Check:** Ensure the small metal potentiometer (trimpot) is facing **UP (towards the same side as the USB-C connector)**.
   - In this orientation:
     - **Left Pin Column (top to bottom):** `ENABLE`, `MS1`, `MS2`, `MS3`, `RESET`, `SLEEP`, `STEP`, `DIR`.
     - **Right Pin Column (top to bottom):** `VMOT`, `GND`, `2B`, `2A`, `1A`, `1B`, `VDD`, `GND`.
3. **Set Up Common Power Rails:**
   - Designate the breadboard's outer bus rails:
     - **Red Bus Rail (+):** 5V DC Motor & Board Power (`VBUS`).
     - **Blue/Black Bus Rail (-):** Common System Ground (`GND`).

---

#### 4.4.2 Phase 1: Single Motor (Motor A) Assembly Sequence

Follow this exact sequential order to build the circuit safely:

##### Step 1: Connect Master Power & Common Ground
* Connect ESP32-S3 SuperMini **Pin 1 (Left Row, `5V`)** to the breadboard **Red Bus Rail (+)** with a red jumper wire.
* Connect ESP32-S3 SuperMini **Pin 2 (Left Row, `GND`)** to the breadboard **Blue/Black Bus Rail (-)** with a black jumper wire.
* *(Note: All components in this circuit must share this single common ground rail).*

##### Step 2: Install Decoupling Capacitor (470 µF 25V)
* Take your **470 µF 25V electrolytic capacitor** (from your inventory).
* **Observe Polarity:** Locate the negative side marked with a thick white or silver band and minus signs (`-`). The shorter lead is negative; the longer lead is positive (`+`).
* Insert the **Negative Lead (-)** into the breadboard row connected to the Ground Rail (`GND`).
* Insert the **Positive Lead (+)** into the breadboard row directly connected to A4988 **Pin 1 (Right Column, `VMOT`)**.
* **Proximity Rule:** Ensure the capacitor legs sit within **1 to 2 cm** of A4988 `VMOT` and `GND`. This absorbs destructive LC inductive kickback voltage spikes from the stepper coils.

##### Step 3: Wire A4988 Power & Ground Pins
* Connect A4988 **Pin 1 (Right Column, `VMOT`)** to the breadboard **Red Bus Rail (+5V)**.
* Connect A4988 **Pin 2 (Right Column, Motor `GND`)** to the breadboard **Ground Rail (-)**.
* Connect ESP32-S3 SuperMini **Pin 3 (Left Row, `3V3`)** directly to A4988 **Pin 7 (Right Column, `VDD`)** with an orange jumper wire. This provides regulated 3.3V logic power matching ESP32 GPIO logic thresholds.
* Connect A4988 **Pin 8 (Right Column, Logic `GND`)** to the breadboard **Ground Rail (-)** with a black wire.

##### Step 4: Hardware Jumper Strapping (RESET ↔ SLEEP)
* Insert a short U-shaped jumper wire directly between A4988 **Pin 5 (Left Column, `RESET`)** and A4988 **Pin 6 (Left Column, `SLEEP`)**.
* *Why this is mandatory:* Both pins are active-low inputs. Tying them together pulls `RESET` high through `SLEEP`'s internal pull-up, enabling the internal translator logic. Without this link, the driver remains in perpetual reset and the motor will never move.

##### Step 5: Connect 28BYJ-48 Stepper Motor Wires (Motor A)
* Ensure your 28BYJ-48 has been modified to 4-wire bipolar (center PCB red trace cut, as described in Section 2).
* Cut or insulate the **Red wire** with electrical tape or heat shrink. It must **not** connect to anything.
* Connect the four coil wires to A4988 motor output pins according to measured coil pairs:
  1. **Phase 1 (+) :** Connect **Blue Wire** to A4988 **Pin 5 (Right Column, `1A`)**.
  2. **Phase 1 (-) :** Connect **Yellow Wire** to A4988 **Pin 6 (Right Column, `1B`)**.
  3. **Phase 2 (+) :** Connect **Pink Wire** to A4988 **Pin 4 (Right Column, `2A`)**.
  4. **Phase 2 (-) :** Connect **Orange Wire** to A4988 **Pin 3 (Right Column, `2B`)**.

##### Step 6: Wire Motor A Control Lines
* **STEP Pulse:** Connect ESP32-S3 SuperMini **Pin 1 (Right Row, `5` / GPIO 5)** to A4988 **Pin 7 (Left Column, `STEP`)**.
* **DIR Direction:** Connect ESP32-S3 SuperMini **Pin 2 (Right Row, `6` / GPIO 6)** to A4988 **Pin 8 (Left Column, `DIR`)**.
* **ENABLE Control:** Connect ESP32-S3 SuperMini **Pin 3 (Right Row, `7` / GPIO 7)** to A4988 **Pin 1 (Left Column, `ENABLE`)**.

##### Step 7: Wire Shared Microstepping Bus (MS1, MS2, MS3)
* **MS1 Line:** Connect ESP32-S3 SuperMini **Pin 6 (Left Row, `1` / GPIO 1)** to A4988 **Pin 2 (Left Column, `MS1`)**.
* **MS2 Line:** Connect ESP32-S3 SuperMini **Pin 7 (Left Row, `2` / GPIO 2)** to A4988 **Pin 3 (Left Column, `MS2`)**.
* **MS3 Line:** Connect ESP32-S3 SuperMini **Pin 9 (Left Row, `4` / GPIO 4)** to A4988 **Pin 4 (Left Column, `MS3`)**.
  > [!IMPORTANT]
  > **Clean Outer Pin Hookup:** GPIOs `1`, `2`, and `4` are located on the left outer header row (Pins 6, 7, and 9). GPIO `3` (Pin 8) is a boot strapping pin and is safely bypassed.

---

#### 4.4.3 Phase 2: Adding Motor B for Dual Motor Testing

Once Motor A is verified and rotating smoothly, add Motor B (Y-Axis) to achieve coordinated 2D beam steering:

##### Step 1: Mount Driver B & Second Capacitor
* Insert the second A4988 module (Driver B) adjacent to Driver A with its trimpot facing **UP**.
* Install your second capacitor (e.g. 470 µF 25V or 47 µF 16V/25V) across Driver B's `VMOT` and `GND` pins (observing polarity: `-` band to GND, `+` to VMOT).

##### Step 2: Wire Power & Strapping for Driver B
* Connect Driver B **`VMOT`** to the breadboard **Red 5V Rail**.
* Connect Driver B **Motor `GND`** and **Logic `GND`** to the breadboard **Ground Rail**.
* Connect Driver B **`VDD`** to the **3.3V Logic Rail** (or directly to ESP32 Pin 3 `3V3`).
* Insert a short jumper between Driver B **`RESET`** and **`SLEEP`**.

##### Step 3: Daisy-Chain the Shared Microstepping Bus
* Connect a jumper from Driver A **`MS1`** to Driver B **`MS1`** (both controlled by `GPIO 1`).
* Connect a jumper from Driver A **`MS2`** to Driver B **`MS2`** (both controlled by `GPIO 2`).
* Connect a jumper from Driver A **`MS3`** to Driver B **`MS3`** (both controlled by `GPIO 4`).
* *(Both drivers will now switch microstep resolutions synchronously from a single serial command!)*

##### Step 4: Wire Motor B Independent Control Lines
* **STEP Pulse B:** Connect ESP32-S3 SuperMini **Pin 5 (Right Row, `9` / GPIO 9)** to Driver B **`STEP`**.
* **DIR Direction B:** Connect ESP32-S3 SuperMini **Pin 6 (Right Row, `10` / GPIO 10)** to Driver B **`DIR`**.
* **ENABLE Control B:** Connect ESP32-S3 SuperMini **Pin 7 (Right Row, `11` / GPIO 11)** to Driver B **`ENABLE`**.

##### Step 5: Connect Motor B Coil Wires
* Connect Motor B's 4-wire modded bipolar cable according to measured coil pairs:
  - **Blue Wire** $\to$ Driver B `1A`
  - **Yellow Wire** $\to$ Driver B `1B`
  - **Pink Wire** $\to$ Driver B `2A`
  - **Orange Wire** $\to$ Driver B `2B`
  - **Red Wire** $\to$ Cut / Not Connected

---

#### 4.4.4 Complete Master Pin Wiring Interconnection Matrix

Use this master lookup table to double-check every wire on your breadboard before applying power:

| Signal / Net Name | ESP32-S3 SuperMini Physical Pin | A4988 Driver A Pin | A4988 Driver B Pin | Target / Destination | Wire Color Suggestion |
|---|---|---|---|---|---|
| **5V Motor Power** | Pin 1 (Left Row, `5V`) | Pin 1 Right (`VMOT`) | Pin 1 Right (`VMOT`) | Cap (+) $\to$ Breadboard 5V Rail | **Red** |
| **Common Ground** | Pin 2 (Left Row, `GND`) | Pin 2 & 8 Right (`GND`) | Pin 2 & 8 Right (`GND`) | Cap (-) $\to$ Ground Rail | **Black / Grey** |
| **3.3V Logic Supply** | Pin 3 (Left Row, `3V3`) | Pin 7 Right (`VDD`) | Pin 7 Right (`VDD`) | Driver Logic Power | **Orange** |
| **UART0 TX Serial** | Pin 4 (Left Row, `TX`) | — (Not connected) | — (Not connected) | Debug Console / Flashing | **Blue** |
| **UART0 RX Serial** | Pin 5 (Left Row, `RX`) | — (Not connected) | — (Not connected) | Debug Console / Flashing | **Green** |
| **Microstep Bit 1** | Pin 6 (Left Row, `1` / GPIO 1) | Pin 2 Left (`MS1`) | Pin 2 Left (`MS1`) | Shared Microstep Bus | **Cyan / Blue** |
| **Microstep Bit 2** | Pin 7 (Left Row, `2` / GPIO 2) | Pin 3 Left (`MS2`) | Pin 3 Left (`MS2`) | Shared Microstep Bus | **Green** |
| **Microstep Bit 3** | Pin 9 (Left Row, `4` / GPIO 4) | Pin 4 Left (`MS3`) | Pin 4 Left (`MS3`) | Shared Microstep Bus | **Purple** |
| **Motor A STEP** | Pin 1 (Right Row, `5` / GPIO 5) | Pin 7 Left (`STEP`) | — (Not connected) | Driver A Step Trigger | **Yellow** |
| **Motor A DIR** | Pin 2 (Right Row, `6` / GPIO 6) | Pin 8 Left (`DIR`) | — (Not connected) | Driver A Direction | **White** |
| **Motor A ENABLE** | Pin 3 (Right Row, `7` / GPIO 7) | Pin 1 Left (`ENABLE`) | — (Not connected) | Driver A Active LOW Enable | **Brown** |
| **Motor B STEP** | Pin 5 (Right Row, `9` / GPIO 9) | — (Not connected) | Pin 7 Left (`STEP`) | Driver B Step Trigger | **Yellow** |
| **Motor B DIR** | Pin 6 (Right Row, `10` / GPIO 10)| — (Not connected) | Pin 8 Left (`DIR`) | Driver B Direction | **White** |
| **Motor B ENABLE** | Pin 7 (Right Row, `11` / GPIO 11)| — (Not connected) | Pin 1 Left (`ENABLE`) | Driver B Active LOW Enable | **Brown** |
| **Status LED** | Pin 9 (Right Row, `13` / GPIO 13)| — (Not connected) | — (Not connected) | Built-in / Onboard Indicator | **Onboard SMD** |
| **Driver A Sleep** | — | Pin 6 Left (`SLEEP`) | — | Jumper to Driver A `RESET` | **Short wire** |
| **Driver A Reset** | — | Pin 5 Left (`RESET`) | — | Jumper to Driver A `SLEEP` | **Short wire** |
| **Driver B Sleep** | — | — | Pin 6 Left (`SLEEP`) | Jumper to Driver B `RESET` | **Short wire** |
| **Driver B Reset** | — | — | Pin 5 Left (`RESET`) | Jumper to Driver B `SLEEP` | **Short wire** |
| **Motor A Coil 1A** | — | Pin 5 Right (`1A`) | — | Motor A Blue Wire | **Blue** |
| **Motor A Coil 1B** | — | Pin 6 Right (`1B`) | — | Motor A Yellow Wire | **Yellow** |
| **Motor A Coil 2A** | — | Pin 4 Right (`2A`) | — | Motor A Pink Wire | **Pink** |
| **Motor A Coil 2B** | — | Pin 3 Right (`2B`) | — | Motor A Orange Wire | **Orange** |
| **Motor B Coil 1A** | — | — | Pin 5 Right (`1A`) | Motor B Blue Wire | **Blue** |
| **Motor B Coil 1B** | — | — | Pin 6 Right (`1B`) | Motor B Yellow Wire | **Yellow** |
| **Motor B Coil 2A** | — | — | Pin 4 Right (`2A`) | Motor B Pink Wire | **Pink** |
| **Motor B Coil 2B** | — | — | Pin 3 Right (`2B`) | Motor B Orange Wire | **Orange** |

---

#### 4.4.5 Critical Pre-Power Safety Checklist & Multimeter Validation

Before plugging in your USB-C cable or powering the system, perform these **five mandatory multimeter tests**:

1. **Test 1: Power-to-Ground Short Circuit Test**
   - Set your multimeter to **Continuity Beep / Resistance ($\Omega$) mode**.
   - Place the black probe on the breadboard **GND Rail** and the red probe on the **5V Red Rail**.
   - **Expected Result:** The meter must **not** continuously beep. The resistance reading should start low as the 470 µF capacitor charges from the meter's test voltage, then climb steadily into hundreds of kilo-ohms ($\text{k}\Omega$) or mega-ohms ($\text{M}\Omega$). If it reads $0.0\,\Omega$, STOP immediately and locate the short circuit before plugging in USB!
2. **Test 2: Capacitor Polarity Verification**
   - Visually check that the negative stripe (`-`) of the 470 µF capacitor is firmly inserted into the **GND** rail, and the positive lead connects to `VMOT`. Reversing electrolytic capacitor polarity will cause the capacitor to overheat or pop!
3. **Test 3: Motor Coil Resistance Verification**
   - Measure resistance across the pairs of motor wires:
     - Probe **Blue** and **Pink**: Must measure $\approx 90\text{–}110\,\Omega$ (Phase A healthy).
     - Probe **Yellow** and **Orange**: Must measure $\approx 90\text{–}110\,\Omega$ (Phase B healthy).
     - Probe **Blue** and **Yellow**: Must read **Infinite / Open Loop (`OL`)** (Phases are fully isolated).
     - Probe **Red** (cut wire) to any color: Must read **Infinite / Open Loop (`OL`)**.
4. **Test 4: Vref Current Adjustment**
   - Plug the ESP32-S3 SuperMini into USB.
   - Attach your multimeter black probe to GND.
   - Gently touch the red probe to the metal screw of the A4988 trimpot.
   - Measure DC millivolts: adjust the trimpot with an insulated screwdriver until it reads **`120 mV` (0.12 V)**.
5. **Test 5: Never Hot-Plug Stepper Motors**
   - **GOLDEN RULE:** NEVER plug in or unplug a stepper motor connector while the 5V power is connected or the driver is energized. The collapsing magnetic field in the coil produces a massive flyback inductive spike that will permanently destroy the A4988 output MOSFETs in microseconds! Always disconnect USB power before touching motor wires.

---

## 5. Microstepping Resolution & Kinematics Table

The 28BYJ-48 features a 4-stage internal spur reduction gearbox. 
- Rotor: 32 full steps per revolution (11.25° step angle).
- Gear ratio: $63.68395 : 1$ (commonly approximated as $64:1$).
- Full-step output resolution: $32 \times 64 = 2048$ steps per revolution.

| Mode | Command | MS1 | MS2 | MS3 | Steps/Rev | Deg / Step | Arcmin / Step | Arcsec / Step | Mirror Res (@ 100mm) |
|---|---|---|---|---|---|---|---|---|---|
| **1/1 Full** | `MICRO 1` | LOW | LOW | LOW | **2,048** | 0.1758° | 10.55' | 632.8" | 306 µm |
| **1/2 Half** | `MICRO 2` | HIGH | LOW | LOW | **4,096** | 0.0879° | 5.27' | 316.4" | 153 µm |
| **1/4 Quarter**| `MICRO 4` | LOW | HIGH | LOW | **8,192** | 0.0439° | 2.64' | 158.2" | 76 µm |
| **1/8 Eighth** | `MICRO 8` | HIGH | HIGH | LOW | **16,384** | 0.0220° | 1.32' | 79.1" | 38 µm |
| **1/16 16th**  | `MICRO 16`| HIGH | HIGH | HIGH| **32,768** | 0.0110° | 0.66' | 39.5" | **19 µm** |

> [!NOTE]
> **Optical Reflection Multiplier:**  
> When steering a laser beam with a mirror, rotation of the mirror by an angle $\theta$ deflects the reflected beam by **$2\theta$** (Law of Reflection). 
> At 1/16 microstepping, each individual microstep delivers an optical beam resolution of **0.022° (1.32 arcmin)**!

---

## 6. Arduino IDE & Board Configuration

### Board Settings (Tools Menu)

| Setting | Selection | Purpose |
|---|---|---|
| **Board** | `ESP32S3 Dev Module` | Standard core for ESP32-S3 |
| **USB Mode** | `Hardware CDC and JTAG` / `USB-OTG` | Native USB communication |
| **USB CDC On Boot** | **`Enabled`** | **Mandatory** for Serial Monitor over USB-C |
| **Upload Mode** | `UART0 / Hardware CDC` | Automatic flashing |
| **Flash Size** | `4MB` or `8MB` | Match your SuperMini flash |
| **Partition Scheme**| `Default 4MB with spiffs` | Standard layout |
| **PSRAM** | `Disabled` | SuperMini does not feature external PSRAM |
| **CPU Frequency** | `240MHz` | Full performance for precision microsecond pulses |

---

## 7. Phase-by-Phase Testing Roadmap

Follow these 7 structured validation phases sequentially:

---

### Phase 1: Cold Logic Verification (VMOT OFF)

**Objective:** Verify ESP32-S3 GPIO outputs, serial commands, and microstepping pin states before turning on 5V motor power.

1. Disconnect 5V VMOT supply (or leave supply turned OFF). Keep USB-C plugged in.
2. Open Serial Monitor at **115200 baud** (Newline).
3. Confirm boot banner appears:
   ```text
   +==================================================+
   |   STEPPER MOTOR & A4988 DRIVER TEST FIRMWARE     |
   |   ESP32-S3 Super Mini  |  Dual 28BYJ-48 Bipolar  |
   +==================================================+
   ```
4. Type `STATUS` and press Enter. Verify:
   - Drivers Enabled: `NO  (Outputs High-Z)`
   - Positions: `A=0, B=0`
5. Test microstepping pin switching:
   - Type `MICRO 16`. Verify response: `[MICRO] Microstepping set to 1/16. Effective steps/rev = 32768.`
   - Measure voltage with DMM on pins MS1, MS2, MS3: All three must read **3.3V**.
   - Type `MICRO 1`. Measure MS1, MS2, MS3: All three must read **0.0V**.
6. **Pass Criteria:** Firmware boots cleanly, commands respond, GPIO logic transitions properly.

---

### Phase 2: Motor A Rotation & Direction (VMOT ON)

**Objective:** Confirm coil wiring, holding torque, and forward/reverse rotation on Motor A.

1. Turn ON the external 5V VMOT power supply.
2. Type `ENABLE`.
   - You should feel holding torque on the Motor A output shaft (it will resist turning by hand).
3. Type `STEP 200`.
   - Motor A should smoothly take 200 steps clockwise.
4. Type `STEP -200`.
   - Motor A should step 200 steps counter-clockwise, returning to the starting point.
5. Type `REV 1`.
   - Motor A should rotate exactly one full revolution of the output shaft (2048 steps).
6. **Pass Criteria:** Motor turns smoothly without clicking, buzzing, or running backwards.

---

### Phase 3: Speed Characterisation & Stall Limit

**Objective:** Determine the maximum reliable pulse rate and torque drop-off threshold.

1. Test conservative stepping speed:
   - `SPEED 300` $\implies$ Motor spins continuously at ~8.8 RPM.
   - Type `STOP` to halt.
2. Step speed progression:
   - `SPEED 500` $\implies$ Verify smooth rotation.
   - `SPEED 800` $\implies$ Normal upper speed limit in full-step mode.
   - `SPEED 1200` $\implies$ Listen for skipped steps or high-pitched rotor stall.
3. Automated stall diagnostic:
   - Type `STALL 800 2048`.
   - The firmware measures execution duration with microsecond timers and reports timing variance.
4. **Pass Criteria:** Motor completes continuous rotation up to 600–800 steps/sec in full-step mode without losing synchronisation.

---

### Phase 4: Microstepping Transitions (1/1 to 1/16)

**Objective:** Verify smooth acoustic resonance suppression and fine step resolution.

1. Set Half-Step:
   - `MICRO 2`
   - `REV 1` (Motor performs 4,096 pulses per rev; noticeably quieter).
2. Set 1/16 Microstepping:
   - `MICRO 16`
   - `REV 1` (Motor performs 32,768 pulses per rev; near-silent gear glide).
3. Observe output shaft:
   - Motion is ultra-smooth with zero step-induced vibration, ideal for laser mirrors.
4. **Pass Criteria:** At 1/16 microstepping, motor operates silently without resonance vibration.

---

### Phase 5: Gear Backlash Characterisation

**Objective:** Measure internal spur gearbox hysteresis (gear play) when reversing direction.

1. Type `BACKLASH`.
2. Firmware runs a 3-second countdown.
3. Observe the output shaft / mirror indicator:
   - Motor pre-loads forward by +200 steps.
   - Firmware steps reverse in increments of: 5, 10, 15, 20, 25, 30, 40 steps.
4. Note the step threshold at which physical movement is visually detected upon reversing.
5. **Pass Criteria:** Backlash is quantified (typically 15 to 30 steps / 0.5° to 1.0°). Use this value to configure software backlash compensation.

---

### Phase 6: Dual-Axis Coordinated Vectoring (Square, Circle)

**Objective:** Verify synchronous dual-axis motion (Bresenham / DDA interpolation) for X-Y mirror rastering.

1. Test diagonal simultaneous step:
   - `DUAL STEP 500 500`
   - Both motors step synchronously at 45°.
2. Test coordinated square:
   - `DUAL SQUARE 600`
   - Motor A and B draw a closed square polygon and return to start.
3. Test coordinated circle:
   - `DUAL CIRCLE 400 32`
   - Coordinated sine/cosine trajectory tracing.
4. Test automated return:
   - `DUAL HOME`
   - Both axes smoothly return to coordinate `(0, 0)`.
5. **Pass Criteria:** Both axes move simultaneously without binding or timing jitter.

---

### Phase 7: Full Automated Self-Test & Benchmark

**Objective:** Execute automated hardware self-test suite and measure ESP32-S3 interrupt/timer headroom.

1. Type `TEST`.
   - Firmware runs all 6 hardware tests: LED, Microstepping logic, Motor A motion, Motor B motion, Dual diagonal vector, and Microstepping resolution switch.
   - Verify `ALL SELF-TEST CHECKS PASSED [OK]`.
2. Type `BENCHMARK`.
   - ESP32-S3 evaluates raw GPIO step generation and DDA math overhead.
   - Observe step pulse capability exceeds 100 kHz (far above 28BYJ-48 requirement).
3. **Pass Criteria:** All automated diagnostics report `PASS`.

---

## 8. Troubleshooting Guide

| Symptom | Probable Cause | Corrective Action |
|---|---|---|
| **Motor hums / whines loudly but does not turn** | 1. Coil wiring swapped (e.g. Phase A and B crossed)<br>2. Step rate exceeds motor starting torque<br>3. $V_{ref}$ set too low ($< 80\,\text{mV}$)<br>4. 5V VMOT supply absent | 1. Check wire pairs with DMM: Blue-Pink must be ~100Ω, Orange-Yellow ~100Ω.<br>2. Reduce speed: Try `SPEED 200`.<br>3. Adjust $V_{ref}$ to 120 mV.<br>4. Verify 5V VMOT rail with DMM. |
| **Motor shaft spins backwards** | Direction inverted | Type `DIR CCW` to invert logic, or swap the Blue and Pink wires on the A4988 header. |
| **Motor gets excessively hot (> 60°C)** | 1. $V_{ref}$ calibrated too high ($> 180\,\text{mV}$)<br>2. Motor left energized while stationary | 1. Re-adjust trimpot to 120 mV.<br>2. Confirm `AUTODISABLE 1` is active (de-energizes coils after 30s idle). |
| **A4988 driver cuts out intermittently** | Driver thermal shutdown (overheating) | 1. Check $V_{ref}$; lower if necessary.<br>2. Attach adhesive aluminum heatsink to A4988 IC.<br>3. Ensure logic VDD is 3.3V, not 5V. |
| **Motor stutters or loses steps at high speed** | Rotor inertia stall (characteristic of 28BYJ-48) | 1. Switch to microstepping (`MICRO 4` or `MICRO 16`).<br>2. Use acceleration ramps rather than instantaneous full-speed jumps. |
| **Serial Monitor displays garbled symbols** | Baud rate mismatch | Set Serial Monitor baud rate to **115200**. |
| **Serial Monitor empty / no port found** | `USB CDC On Boot` disabled | In Arduino IDE Tools menu, set `USB CDC On Boot = Enabled` and re-flash. |

---

## 9. Serial Command Reference

> [!NOTE]
> **Motor target syntax:** Commands marked `[A|B|BOTH]` default to **Motor A** when no target is given. Accepted aliases are `A`/`X` (Motor A), `B`/`Y` (Motor B), and `BOTH`/`ALL`/`AB` (both motors). These strings are case-insensitive.
>
> **Speed sign convention:** A **positive** speed runs CW; a **negative** speed runs CCW.

### 9.1 Motor Run & Move Commands

| Command | Arguments | Example | Description |
|---|---|---|---|
| `START` | `[A\|B\|BOTH] [sps]` | `START B 100` / `START 100` | Run motor(s) continuously. Defaults to Motor A at 100 sps. |
| `STEP` | `[A\|B\|BOTH] <n> [sps]` | `STEP 500` / `STEP B 200 100` | Step motor(s) by $N$ microsteps (+ forward, - reverse). Defaults to 100 steps. |
| `SPEED` | `[A\|B\|BOTH] <sps>` | `SPEED 600` / `SPEED B 100` | Set speed and start continuous motion. With no argument, reports configured A & B speeds. |
| `STOP` | `[A\|B\|ALL]` | `STOP` / `STOP B` | Stop continuous motion (single motor or all). |
| `GOTO` | `[A\|B] <pos> [sps]` | `GOTO 2048` / `GOTO B 500 400` | Move motor to absolute step coordinate. |
| `REV` | `[A\|B\|BOTH] <n> [sps]` | `REV 1.5` / `REV B -2 300` | Move motor(s) by exact number of output revolutions. |
| `DIR` | `[A\|B\|BOTH] <CW\|CCW>` | `DIR CCW` / `DIR B CW` | Invert/restore default rotation direction. Also accepts `FORWARD`/`REVERSE`. No argument reports current setting. |
| `POS` | *None* | `POS` | Report current step positions, angles, and revolutions. |
| `ZERO` | *None* | `ZERO` | Reset both axis position counters to 0 (Home). |
| `RPM` | *None* | `RPM` | Display configured and live rotational speeds in RPM. |
| `MICRO` | `<1\|2\|4\|8\|16>` | `MICRO 16` | Set microstepping mode via MS1/MS2/MS3 pins. |
| `ENABLE` | *None* | `ENABLE` | Assert driver ENABLE pin (active LOW, energized). |
| `DISABLE`| *None* | `DISABLE` | Release driver ENABLE pin (high-Z, coils off). |

### 9.2 Dual Motor (A + B) Commands

| Command | Arguments | Example | Description |
|---|---|---|---|
| `DUAL STEP` | `<nA> <nB>` | `DUAL STEP 200 400` | Step Motor A and Motor B simultaneously. |
| `DUAL GOTO` | `<xA> <yB>` | `DUAL GOTO 1000 1000` | Coordinated Bresenham move to $(X, Y)$ coordinate. |
| `DUAL SPEED`| `<sA> <sB>` | `DUAL SPEED 600 600` | Configure default individual speeds for A and B. |
| `DUAL CIRCLE`| `<radius> [segs]` | `DUAL CIRCLE 500 48` | Trace parametric circular vector path (8–360 segments). |
| `DUAL SQUARE`| `<size>` | `DUAL SQUARE 600` | Trace square vector path of side length $S$. |
| `DUAL HOME`| *None* | `DUAL HOME` | Return both axes back to $(0, 0)$ coordinate. |

### 9.3 Diagnostics & System Commands

| Command | Arguments | Example | Description |
|---|---|---|---|
| `BACKLASH`| *None* | `BACKLASH` | Run spur gear backlash diagnostic sequence. |
| `STALL` | `<sps> <steps>` | `STALL 1000 2048` | High-speed step generator test & jitter analysis. |
| `TEST` | *None* | `TEST` | Execute full automated hardware self-test suite. |
| `BENCHMARK`| *None* | `BENCHMARK` | Measure ESP32-S3 max pulse generation throughput. |
| `ACCEL` | `<sps2>` | `ACCEL 3000` | Set acceleration parameter (steps/sec$^2$). No argument reports current value. |
| `AUTODISABLE`| `<0\|1>` | `AUTODISABLE 1` | Enable/disable 30-second idle driver power cut. No argument reports current state. |
| `ECHO` | *None* | `ECHO` | Toggle command echo on/off. |
| `STATUS` / `?`| *None* | `STATUS` | Print comprehensive status report in ASCII box. |
| `HELP` / `H`| *None* | `HELP` | Print command cheat sheet and safety notes. |
| `RESET` | *None* | `RESET` | Restore all settings to safe defaults, disable drivers. |
| **Abort** | *Key* | `X` / `!` / `SPACE` / `ESC` | **Emergency abort** — instantly halts any active move. |
