mushfiqbinmusa-ops/Laser_Engraver/ir_sensor_test/circuit_diagram.html

# ⚡ ESP32-S3 SuperMini — IR Homing Sensor Circuit Diagram

Exact 18-Pin DIP Layout · Dual FC-51 / LM393 Optical Endstops SuperMini 18-Pin FC-51 / LM393 Optical

🔧 Single Sensor (X Only) ⚙️ Dual Sensor (X + Y) 〰️ Signal Flow: ON

Interactive Circuit — Single Sensor Bring-Up

X Endstop Y Endstop 5 V GND Status LED Divider

### ⚠️ Sensor Stuck DETECTED / CLEAR?

- Always DETECTED: turn the blue trim-pot COUNTER-CLOCKWISE until the green LED turns OFF.
- Always CLEAR: VCC must be on the 5V pin (not 3.3V), then turn trim-pot CLOCKWISE.
- Emitter crosstalk: straighten the clear/dark LEDs parallel; tape between them if needed.
- Run THRESHOLD for live diagnosis.

### ℹ️ Why Direct 5V Is Safe

The ESP32-S3 GPIO tolerates max 3.6V. The onboard green LED + ~1kΩ sit between VCC (5V) and OUT, so the LED forward drop (≈2.0–2.2V) limits OUT to ~2.8–3.2V when clear — perfectly safe.

Measured clear level: < 3.3V

Only add the divider if a clone sensor reads > 3.3V.

### 🔧 Optional Divider (Clones)

OUT ──[10kΩ]──┬──► GPIO 3 / 8
│
[20kΩ]
│
GND

Result: 5V × 20k/(10k+20k) = 3.33V max at the GPIO.

### 📌 Master Pin Interconnection Table

Pin | Signal | Target
5V (1-L) | VBUS 5V | Sensor X & Y VCC
GND (2-L) | Common GND | Sensor X & Y GND
3 (8-L) | Sensor X OUT | X Endstop (Active LOW)
8 (4-R) | Sensor Y OUT | Y Endstop (Active LOW)
13 (9-R) | Status LED | Detection Mirror
12 (8-R) | Laser PWM | Reserved
5,6,7,9,10,11 | Stepper | Reserved (Stepper)
1,2,4 (MS) | Microstep | Reserved (Stepper)

### ▶ Command Simulator

Click to test firmware responses:

READ MONITOR 100 CALIB THRESHOLD DEBOUNCE DUAL STATUS

[BOOT] ESP32-S3 SuperMini IR Sensor Test Ready. [INIT] Sensor X Pin : GPIO 3 (Input Pull-up) [INIT] Sensor Y Pin : GPIO 8 (Input Pull-up) [INIT] Status LED : GPIO 13 Baud: 115200 | Type HELP for command list...
