mushfiqbinmusa-ops/Laser_Engraver/stepper_motor_test/circuit_diagram.html

# ⚡ ESP32-S3 SuperMini — Stepper Motor Circuit Diagram

Exact 18-Pin DIP Layout · Dual A4988 · Bipolar 28BYJ-48 SuperMini 18-Pin Bipolar Mod

🔧 Single Motor (A Only) ⚙️ Dual Motor (A + B) 〰️ Signal Flow: ON

Interactive Circuit — Single Motor Bring-Up

STEP DIR EN MS Bus 5 V 3.3 V GND

### ⚠️ Motor Not Spinning? Check List

- RESET ↔ SLEEP: Jumper wire MUST connect RESET directly to SLEEP. If missing, driver stays in sleep mode!
- Holding Torque: Type ENABLE. If shaft turns freely, no coil power is reaching the motor.
- VREF Tuning: Multimeter on trimpot screw must measure 0.12V (120 mV). If 0V, current is shut off.
- Slow Speed Test: SPEED 100 then STEP 500.

### ℹ️ One Firmware, Two Modes

stepper_motor_test.ino is unified for both Single and Dual test modes.

- Single Motor: Wire Motor A only. Run STEP, SPEED, BACKLASH.
- Dual Motor: Add Motor B. Run DUAL STEP, DUAL CIRCLE.

### ⚡ Capacitor Selection

Your stock: 47 µF (16V), 470 µF (25V), 1000 µF (25V).

Use the 470 µF 25V!

Minus (−) band to GND rail, (+) long leg to VMOT rail. Keep within 1–2 cm of A4988 pins.

### 📌 Master Pin Interconnection Table

Pin | Function | Target
5V (Pin 1-L) | USB 5V | Cap (+) → A4988 VMOT
GND (Pin 2-L) | Common GND | Cap (−) / A4988 GND
3V3 (Pin 3-L) | 3.3V Logic | A4988 VDD
TX (Pin 4-L) | UART0 TX | Serial Debug / Upload
RX (Pin 5-L) | UART0 RX | Serial Console Input
1 (Pin 6-L) | MS1 Bus | A4988 MS1 (Shared)
2 (Pin 7-L) | MS2 Bus | A4988 MS2 (Shared)
4 (Pin 9-L) | MS3 Bus | A4988 MS3 (Shared)
5 (Pin 1-R) | STEP (X) | Driver A STEP
6 (Pin 2-R) | DIR (X) | Driver A DIR
7 (Pin 3-R) | EN (X) | Driver A ENABLE
9 (Pin 5-R) | STEP (Y) | Driver B STEP
10 (Pin 6-R) | DIR (Y) | Driver B DIR
11 (Pin 7-R) | EN (Y) | Driver B ENABLE
13 (Pin 9-R) | LED | Onboard Indicator

### ▶ Command Simulator

Click to test firmware responses:

ENABLE STEP 500 SPEED 100 MICRO 1 REV 1 DUAL STEP STATUS

[BOOT] ESP32-S3 SuperMini Stepper Test Ready. [INFO] Baud: 115200 | Motors Disabled (Cold Start). Type or click commands above…
