mushfiqbinmusa-ops/Laser_Engraver/(commit log)

2026-10-09 feat(laser): add working laser pwm test firmware and characterization guide
    - Implement full ESP32-S3 LEDC PWM test firmware in laser_pwm_test/laser_pwm_test.ino
    - Add hard-pull LOW on duty 0 and boot to prevent premature firing
    - Verify working PWM control via GPIO 10 with hardware switch engaged
    - Add TESTING_GUIDE.md and system plan laser_engraver_plan.md
2026-10-16 feat: add full engraver firmware, backend server, UI, and documentation
    - Normalize 3D parts directory naming to Laser_XY_3D_Parts and add ESP32-S3 CAD/videos
    - Add modular laser-engraver-firmware with G-code parsing, motion control, homing, laser PWM, and WiFi server
    - Implement laser-engraver-server with FastAPI, SVG processor, ESP32 bridge (Serial/TCP), SQLite job tracking, and web UI
    - Add command reference documentation and hardware pinout assets
    - Update .gitignore to exclude Python cache, test cache, and virtual environments
2026-10-16 feat(stepper): add dual stepper motor and A4988 test firmware and testing guide
    - Implement full ESP32-S3 test firmware in stepper_motor_test/stepper_motor_test.ino
    - Support single-motor control, continuous motion, microstepping (1/1 to 1/16), and safety limits
    - Support dual-axis coordinated motion using Bresenham/DDA (circle, square, diagonal, home)
    - Add backlash characterization, stall detection, benchmark, and self-test routines
    - Provide comprehensive TESTING_GUIDE.md with Mermaid diagrams, ASCII art wiring, Vref formulas, and troubleshooting
2026-10-16 feat(homing): add IR obstacle sensor test firmware and comprehensive testing guide
    - Add full ESP32-S3 test firmware in ir_sensor_test/ir_sensor_test.ino matching laser_pwm_test style
    - Support single and continuous monitoring, calibration wizard, threshold diagnostic, and range testing
    - Implement microsecond debounce analysis, edge counting, latency profiling, and noise immunity tests
    - Add 2-stage CNC homing approach simulation and dual-sensor synchronization alignment routine
    - Provide comprehensive TESTING_GUIDE.md with Mermaid diagrams, ASCII art wiring, voltage safety notes, and troubleshooting
2026-10-16 feat(homing): add IR obstacle sensor test suite and update documentation for optical homing
    - Add full-featured ir_sensor_test firmware and TESTING_GUIDE.md
    - Update resources/report.md section 4.6 and 6.4/6.6 with IR optical endstop architecture
    - Update resources/laser_engraver_plan.md pinout and BOM.md to reflect optical sensors
2026-10-16 docs(stepper): recreate comprehensive ASCII schematics and add capacitor compatibility analysis
    - Add complete top-view pinouts for ESP32-S3 SuperMini, A4988, and bipolar 28BYJ-48
    - Recreate fully detailed pin-to-pin wiring diagrams for single and dual motor tests
    - Add capacitor selection guide approving 470uF, 1000uF, and 47uF (16V/25V) over strict 100uF requirement
2026-10-16 fix(stepper): update ESP32-S3 SuperMini pinout and add interactive dynamic circuit schematic HTML
2026-10-16 docs(test): add comprehensive written wiring instructions for stepper and IR sensor circuits
2026-10-16 docs(test): align pinouts in both testing guides with 18-pin ESP32-S3 SuperMini layout
2026-10-17 fix(stepper): correct circuit diagram HTML with 18-pin SuperMini layout and A4988 pinout
2026-10-17 feat(stepper): add START and STOP commands for independent motor A and B rotation
2026-10-17 fix(stepper): resolve compile errors in RPM and RESET handlers
2026-10-17 fix(stepper): support motor selection in DIR command and increase DIR pin hold time
2026-10-17 docs(stepper): update motor coil wiring to Blue-Yellow and Pink-Orange pairs across guide and HTML diagram
2026-10-17 docs(stepper): record verified coil pairing note for bidirectional rotation fix
2026-10-17 feat(stepper): expand STEP, SPEED, GOTO, REV commands to support individual motor selection (A, B, or BOTH) and lower default speed to 100 sps
2026-10-18 Enhance stepper motor testing documentation and add unit tests for homing logic
    - Updated TESTING_GUIDE.md to clarify command usage and improve command descriptions.
    - Changed command from `SPEED` to `START` for initiating motor movement.
    - Improved feedback messages for self-test and microstepping commands.
    - Added comprehensive unit tests in test_homing_logic.cpp for command parsing, sensor debounce filtering, and homing state machine logic.
    - Implemented mock environment to simulate Arduino functions for testing.
    - Included assertions to validate expected behavior during homing operations.
2026-10-18 chore: remove prototype firmware and server/UI
2026-10-18 feat(firmware): implement production fail-safe ESP32-S3 firmware with A4988 motion, 2-stage homing, and laser safety
2026-10-18 feat(system): implement vite-react operator station, guarded tests, and e2e integration suite
    - Implemented accessible Vite + React + TypeScript single-page application at client/ with monochrome tokens and semantic crimson/emerald alerts.
    - Built 4 operator tabs: Engrave (SVG upload, TSP preview, job streaming), Calibration/Homing (2-stage optical homing, step jog, coordinates), Settings (machine configuration, persistent presets), and Tests (system ping, driver enable, guarded laser pulse).
    - Mounted production web assets directly into FastAPI server at server/static/ to enable turnkey operator serving.
    - Implemented comprehensive End-to-End integration suite at server/tests/test_e2e_integ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
2026-10-18 feat(firmware): add firmware/firmware.ino sketch entry point for Arduino IDE
2026-10-18 feat(network): implement ESP32-S3 Wi-Fi STA and SoftAP mode with Web UI dynamic controller connection
    - Added firmware/src/config/wifi_config.h for Wi-Fi STA credentials and SoftAP fallback parameters.
    - Implemented dual-mode Wi-Fi initialization in firmware/firmware.ino and firmware/src/main.cpp: attempts router STA connection (10s timeout), automatically falls back to SoftAP ('Laser-XY-Scanner', 'laser1234' on 192.168.4.1), and listens on TCP port 8888.
    - Added GET /api/machine/connection and POST /api/machine/connect in FastAPI routes_machine.py for dynamic controller connection switching.
    - Added Controller Connection management card in client/src/tabs/SettingsTab.tsx with live connectio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
2026-10-18 fix(firmware): resolve WiFiServer::available deprecation on ESP32 Core 3.x using accept()
2026-10-18 feat(ui): add microstep controls, live status query, energize feedback, and stepper motion test
    - Added microstepping resolution profile (A4988 1/16 mode, 80 steps/mm) in CalibrationTab.
    - Added selectable microstep jog increments (1, 8, 16, 40, 80, 160 usteps and custom input) with a directional jog D-pad.
    - Added 'Get Status (system.snapshot)' button in TestsTab with expandable JSON telemetry inspector.
    - Added visual feedback notification banner and holding torque badge for motor driver energize/de-energize.
    - Added dedicated Stepper Motor Motion Test card in TestsTab with Wiggle Test (±steps) and Single Jog options.
    - Updated firmware protocol dispatcher to emit snapshot immediately upo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
2026-10-18 feat(microstep): add hardware microstepping mode selection (1/1, 1/2, 1/4, 1/8, 1/16) and clarify stepper speed limits
2026-10-18 fix(telemetry): live dynamic sensor & homing feedback with 250ms heartbeat and 500ms client polling
2026-10-18 feat: add false engraving, laser pulse test, and fix homing limits
2026-10-21 fix(server): report optical sensors with firmware polarity
    Firmware sets filtered=1 when the beam is blocked (sensor_filter.cpp),
    and the web UI already treats 1 as triggered. The consolidated status
    report inverted this and claimed 0 = DETECTED, which could make an
    operator misread an endstop as clear. Align the report with firmware.
2026-10-21 fix: close job-end race that could truncate the final segment
    The server sent job.end immediately after the final segment ACK, and
    firmware cut laser power and left RunningJob without checking
    planner.isMoving(). On TCP the host never waited at all, so the last
    move could be aborted and the beam blanked mid-segment.
    Firmware now rejects job.end with BUSY while moving. The server retries
    until the move completes (exact completion signal) on every transport.
2026-10-21 fix: make microstepping and steps/mm a single scaled contract
    machine_config steps/mm is calibrated at 1/16, but the UI displayed
    5*mode while the planner always emitted reference steps and firmware
    let the mode change mid-motion. A mode change silently corrupted scale
    and homing validity.
    - Plan toolpaths at 1/16 and rescale segments/speeds to the live mode
    at job start (server/app/core/kinematics.py).
    - Firmware rejects microstep changes while homing/moving/running and
    invalidates homing on a valid change.
    - Status report and calibration UI derive steps/mm from the configured
    reference value instead of hardcoding 5*mode.
    - Label settings as 1/16 reference and surface rejected change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
2026-10-21 fix(laser): centralize duty safety mapping and validate overrides
    Percentage-to-duty was duplicated in the server, presets, and UI, and
    the SVG upload Form accepted any override_int while the shape model
    capped it at 90%. Python's banker's rounding also disagreed with the
    web UI for 45% (1842 vs 1843).
    - Add core/laser.py (half-up pct->duty, hard clamp) and use it in job
    overrides, preset creation, models, and config.
    - Reject upload overrides outside 0..90 with HTTP 400.
    - Add a shared client util so pulse displays use the same mapping.
    - Add migration 002 and align the acrylic seed to 1843.
2026-10-21 fix(homing): align homing contract and UI with firmware
    The hardware profile and calibration UI advertised 120/40 sps and
    4096-step seeks, while firmware runs 800/200 sps with 45000-step seeks
    and a 60s per-phase timeout. The server also gave up after 70s, which
    is not enough for a multi-phase X+Y sequence.
    Update contracts/hardware_profile.json and the UI text to the firmware
    values, and raise the homing operation timeout to 180s.
2026-10-21 fix: align fault state, connection defaults, jog bounds and docs
    - Web UI compared state to 'Faulted' while firmware emits 'faulted',
    so the global fault banner and pulse/driver interlocks never engaged.
    - Connect requests defaulted to TCP 192.168.4.1 even though the server
    defaults to serial; omitted fields now inherit current settings.
    - Firmware only enforced travel bounds when position was valid, so an
    unhomed jog could run past the mechanical limit.
    - Update protocol docs to the real 512-byte frame limit, 60s homing
    timeout and synchronous job ACK lifecycle; mark report.md historical.
2026-10-21 fix(safety): enforce configured travel bounds on jog and move
    machine_config.max_travel_steps_* was editable but unused: the server
    forwarded any target up to the firmware's loose 65536-step sanity cap,
    so the UI could command motion far outside the 50mm work area.
    Enforce the configured bounds server-side, scaled from 1/16 reference
    steps to the live microstep mode, and size the jog input from the same
    limit.
2026-10-21 refactor(server): use laser safety constants in status report
    Avoid a second copy of the 4095/3685 ceiling in the printable report.
2026-10-22 chore: checkpoint current UI, firmware, and server work
2026-10-22 feat: apply preset microstep at job start with homing lifecycle
    - add per-preset microstep mode and persisted default
    - apply preset microstep before jobs and re-home on mode change
    - auto-home after successful jobs and invalidate homing on interrupts
    - update simulator, regression tests, docs, and built UI assets
